chenyurong22/industrial-safety-can/README.md

# Industrial Safety Monitoring CAN Network

A two-node CAN bus safety system built on STM32, demonstrating embedded safety patterns used in automotive and industrial control: message integrity (CRC, counters), heartbeat/watchdog monitoring, and deterministic safe-state transitions. Python-based CAN traffic logger included for analysis.

## Demo

https://github.com/user-attachments/assets/6b3a358f-29fb-43ed-8647-16d2829241f6

*End-to-end demonstration: temperature-driven state changes, live CAN traffic on both consoles, servo actuation, a heartbeat-timeout safe-state trip on bus disconnect, and automatic recovery.*

## Kurzbeschreibung (Deutsch)

Dieses Projekt ist ein sicherheitsgerichtetes CAN-Bus-Netzwerk aus zwei STM32-Knoten. Ein Sensorknoten misst die Temperatur und sendet Datenrahmen mit CRC-Prüfsumme sowie ein Heartbeat-Signal. Ein Überwachungsknoten prüft die Integrität der Nachrichten, steuert einen Aktor zustandsabhängig und geht in einen definierten sicheren Zustand über, wenn der Heartbeat länger als 500 ms ausbleibt. Ein Python-Logger überwacht den Bus unabhängig zur Analyse. Das Projekt orientiert sich an Kommunikations- und Überwachungsmustern aus AUTOSAR-Systemen (z. B. DEM, COM, WdgM), umgesetzt in einfachem HAL-Code.

**Project status:** ✅ Feature complete — 14-day build (Weeks 1–2)

## Table of contents

- [Goals](#goals)
- [CAN frame reference](#can-frame-reference)
- [Hardware](#hardware)
- [Requirements & traceability](#requirements--traceability)
- [Static analysis](#static-analysis)
- [Architecture](#architecture)
- [Repository structure](#repository-structure)
- [Build log](#build-log)
  - [Week 1 — STM32 basics, I2C sensor, UART debugging](#week-1--stm32-basics-i2c-sensor-uart-debugging)
  - [Week 2 — Application-layer integrity, heartbeat, safe state, logging](#week-2--application-layer-integrity-heartbeat-safe-state-logging)
- [Skills demonstrated](#skills-demonstrated)
- [Project achievements](#project-achievements)
- [Author](#author)

## Goals

- Build a working two-node CAN safety network on real hardware
- Demonstrate concepts inspired by communication and supervision patterns commonly used in AUTOSAR systems (e.g. DEM-like diagnostics, COM-like validation, WdgM-like watchdog) in plain HAL code — not AUTOSAR BSW modules themselves
- Produce quantitative timing analysis with a Python logger
- Document the build day-by-day as a learning record

## CAN frame reference

Quick reference for the two message types on the bus (full derivation in the Day 9 and Day 10 build-log entries).

**Sensor frame — CAN ID `0x123`, DLC 8, every 100 ms**

| Byte | 0 | 1 | 2 | 3 | 4–6 | 7 |
|---|---|---|---|---|-----|---|
| Field | Counter | Temp int | Temp frac (×100) | State enum | Reserved | CRC-8 |

State enum: `0 = NORMAL`, `1 = WARNING`, `2 = CRITICAL`. CRC-8 (poly `0x07`) computed over bytes 0–6.

**Heartbeat frame — CAN ID `0x100`, DLC 2, every 200 ms**

| Byte | 0 | 1 |
|---|---|---|
| Field | Counter | Uptime (coarse, `tick/100`) |

Bus: 500 kbit/s, 120 Ω termination at each end, 75 % sample point.

## Hardware

- 2× STM32 Nucleo-F446RE
- 2× SN65HVD230 CAN transceivers
- 1× BME280 temperature/humidity sensor (I2C)
- 1× SG90 servo motor
- 1× Innomaker USB-CAN adapter for PC-side logging
- 120 Ω termination resistors, breadboard, jumper wires

## Requirements & traceability

This project was built against an explicit requirements specification ([`docs/requirements.md`](docs/requirements.md)) — 22 requirements across functional, integrity, and safety categories, each with a rationale and a verification method (test / analysis / inspection) tied to the evidence in the build log below. Requirement IDs are referenced from commit messages to give lightweight V-model traceability from requirement → implementation → demonstrated result.

| Category | IDs | Covers |
|---|-----|---|
| Functional | REQ-F-01 … F-08 | Sensing, state classification with hysteresis, CAN TX/RX, bus parameters, actuation, passive logging |
| Integrity | REQ-I-01 … I-06 | Application-layer CRC-8, rolling counter, lost-frame detection, running statistics, independent PC cross-check |
| Safety | REQ-S-01 … S-08 | Heartbeat liveness, 500 ms watchdog, edge-triggered safe state, fail-safe actuation, auto-recovery, startup grace, rate-limited actuation |

A one-page hazard analysis ([`docs/hara.md`](docs/hara.md)) derives these safety requirements from six identified hazards using an ISO 26262-style Severity / Exposure / Controllability classification.

### Verification matrix

A one-glance view that requirements were actually verified against evidence in the build log. The full per-requirement verification (all 22) is in [`docs/requirements.md`](docs/requirements.md).

| Requirement | What it verifies | Evidence | Status |
|---|---|---|---|
| REQ-F-04 | Sensor frame every 100 ms | Day 9 / Day 13 | ✅ |
| REQ-I-02 | Reject frames failing CRC-8 | Day 9 | ✅ |
| REQ-I-04 | Detect lost frames (counter gap) | Day 9 / Day 11 | ✅ |
| REQ-S-02 | Heartbeat timeout within 500 ms | Day 11 / Day 12 (~501 ms) | ✅ |
| REQ-S-04 | Fail-safe servo position on trip | Day 11 | ✅ |
| REQ-S-06 | Auto-recovery on heartbeat return | Day 11 | ✅ |

## Static analysis

Application code is analysed with **Cppcheck** using the **MISRA C:2012** addon.

- **Tool:** Cppcheck (run `cppcheck --version` and record the version here)
- **Standard:** MISRA C:2012
- **Scope:** application source only — HAL/CMSIS excluded via a suppressions list
- **All mechanically-fixable findings corrected** — explicit type conversions (10.4), boolean conditions (14.4), braced `if` bodies (15.6), `switch` default clauses (16.4)
- **Remaining findings are documented justified deviations** on advisory rules:
  - **8.7** internal-linkage recommendations — functions intentionally shared across both nodes, so cannot be `static`
  - **15.5** single-exit style — per-case returns in small lookup functions, kept for clarity

See [`docs/misra_compliance.md`](docs/misra_compliance.md) for the full report, including the before → after finding counts.

## Architecture

Two STM32 nodes as peers on a shared, terminated CAN bus. Node A senses and transmits; Node B validates, supervises, and actuates. A Python logger taps the bus passively for independent analysis.

```
        NODE A  (Sender / Sensor)                       NODE B  (Receiver / Supervisor)
        ┌───────────────────────┐                       ┌───────────────────────────┐
        │ BME280  (I2C)          │                       │ CRC-8 validation          │
        │   ↓                    │                       │   ↓                       │
        │ State machine          │                       │ Counter / lost-frame check│
        │  (hysteresis)          │                       │   ↓                       │
        │   ↓                    │                       │ Heartbeat watchdog (500ms)│
        │ CRC-8 + rolling counter│                       │   ↓                       │
        │   ↓                    │                       │ Safe-state logic          │
        │ CAN TX:                │                       │   ↓                       │
        │  0x123 sensor  (100ms) │                       │ Servo (PWM) — state /     │
        │  0x100 heartbeat(200ms)│                       │   fail-safe actuation     │
        └───────────┬───────────┘                       └─────────────┬─────────────┘
                    │                                                 │
      ══════════════╪═════════════════ CAN BUS (500 kbit/s) ═════════╪══════════════
       120 Ω term ──┤                         │                       ├── 120 Ω term
                    │                          │                       │
                    │                ┌─────────┴──────────┐            │
                    │                │ Python logger      │            │
                    │                │ (listen-only tap)  │            │
                    │                │ CRC + counter      │            │
                    │                │ re-validation, CSV │            │
                    │                └────────────────────┘            │
```

For the full technical reference — module breakdown, protocol, timing budget, scheduler, state machine, and design limitations — see [`docs/architecture.md`](docs/architecture.md).

## Repository structure

```
Industrial Safety Monitoring CAN Network/
├── CAN_Sender_Node/            # Node A — sensor node: BME280 read, state machine, CAN TX with integrity
├── CAN_Receiver_Node/          # Node B — validator node: CAN RX, CRC + counter validation, watchdog, servo
├── Python Log Code/            # Day 13 — listen-only CAN logger (can_logger.py) + matplotlib report (can_report.py)
├── Project-Snaps/              # screenshots and hardware photos, organised by day
├── docs/
│   ├── requirements.md         # requirements specification with verification + traceability
│   ├── hara.md                 # hazard analysis and risk assessment (ISO 26262-style)
│   ├── architecture.md         # software architecture, protocol, timing, scheduler, state machine
│   └── misra_compliance.md     # MISRA-C:2012 static-analysis report
├── cppcheck_suppressions.txt   # HAL/CMSIS suppressions for the MISRA scan
├── LICENSE                     # MIT
└── README.md
```

## Build log

### Week 1 — STM32 basics, I2C sensor, UART debugging

#### Day 1 (2026-05-13) — Toolchain setup and LED blink

Validated the STM32CubeMX → STM32CubeIDE workflow on a Nucleo-F446RE. Used Board Selector to generate a baseline project — this pre-configures the system clock, PA5 (user LED LD2), PC13 (user button B1), and routes USART2 (PA2/PA3) to the ST-Link virtual COM port. Configured the code generator to emit one `.c/.h` file per peripheral (cleaner than the default single-file dump) and to preserve user code between `/* USER CODE BEGIN ... */` markers on regeneration.

Implemented LED blink three ways to internalise the abstraction layers:
- `HAL_GPIO_TogglePin(LD2_GPIO_Port, LD2_Pin)` — HAL wrapper, function call
- `GPIOA->ODR ^= GPIO_ODR_OD5` — CMSIS read-modify-write
- `GPIOA->BSRR = GPIO_BSRR_BS5` — CMSIS atomic single-cycle write (preferred for ISR safety)

Covered why the BSRR pattern matters once interrupts share a GPIO port with the main loop — a foundation for the multi-LED status indicators planned for Node A.

<p align="center">
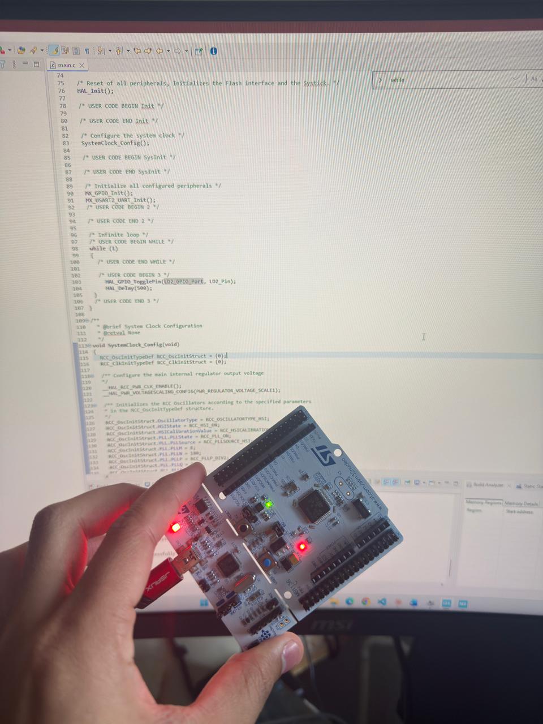
[picture p1: Project-Snaps/day01-blink-toolchain/04-led-blink-hardware.jpeg]
  
  <br>
  <em>First firmware running on hardware — green LD2 blinking at 1 Hz on the Nucleo-F446RE.</em>
</p>

<details>
<summary>Setup screenshots</summary>

<p align="center">
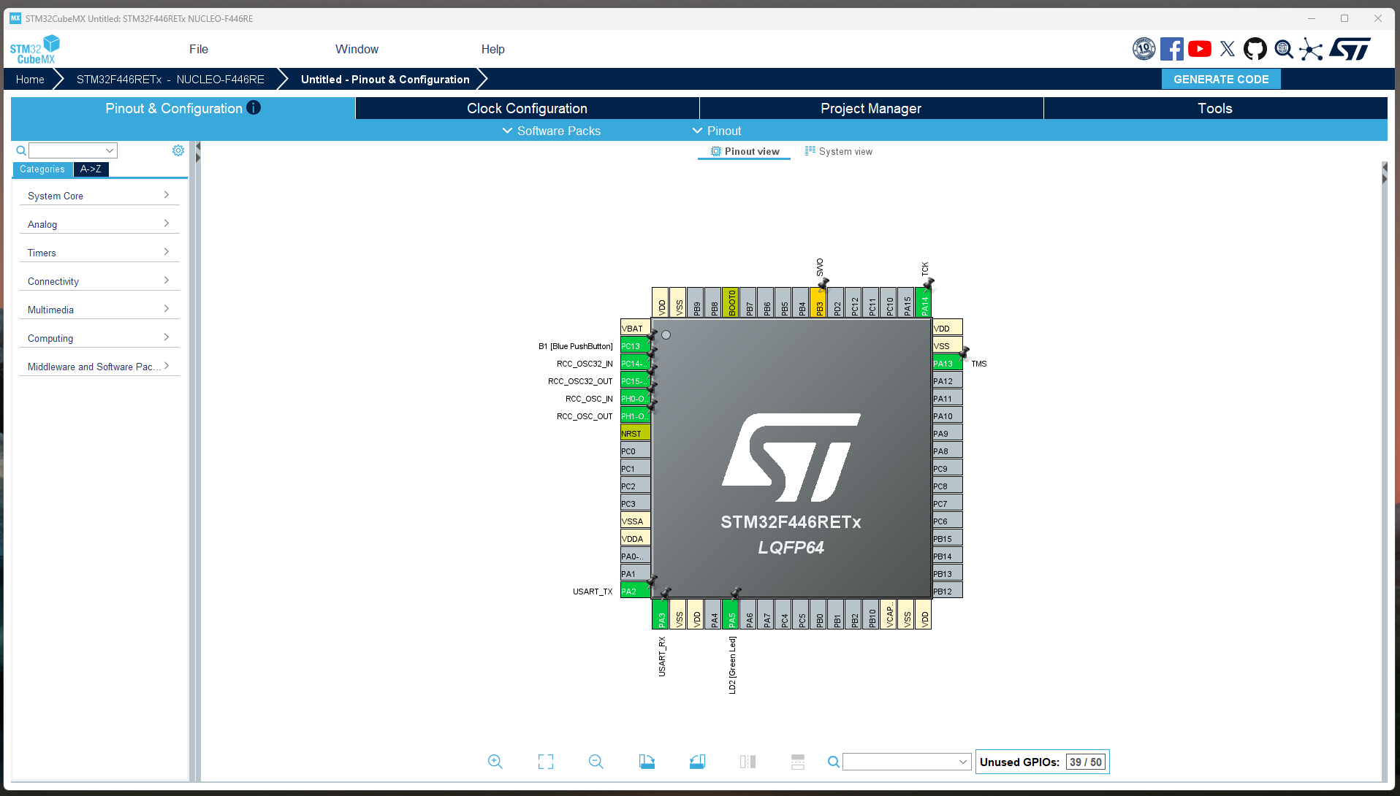
[picture p2: Project-Snaps/day01-blink-toolchain/01-cubemx-board-selector-pinout.png]
  
  <br>
  <em>CubeMX Board Selector pinout view — PA5 (LD2), PA2/PA3 (USART2), PC13 (B1) pre-configured.</em>
</p>

<p align="center">
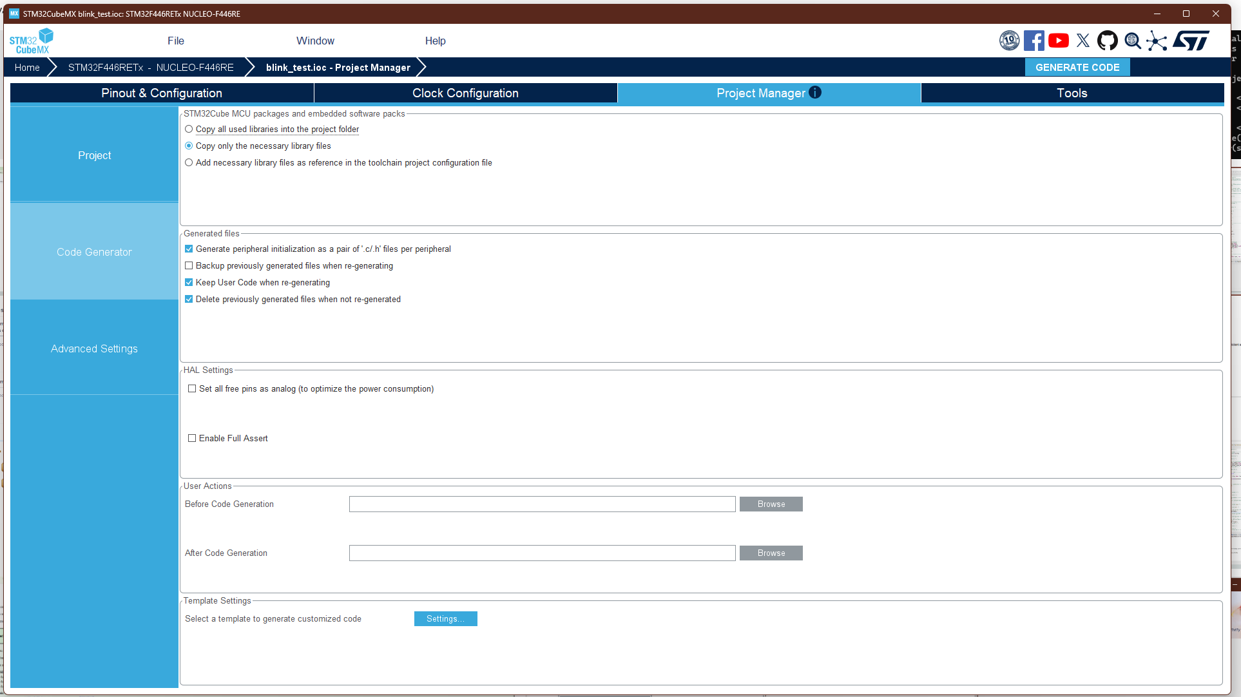
[picture p3: Project-Snaps/day01-blink-toolchain/02-cubemx-code-generator-settings.png]
  
  <br>
  <em>Code Generator settings — per-peripheral file split and user-code preservation enabled.</em>
</p>

<p align="center">
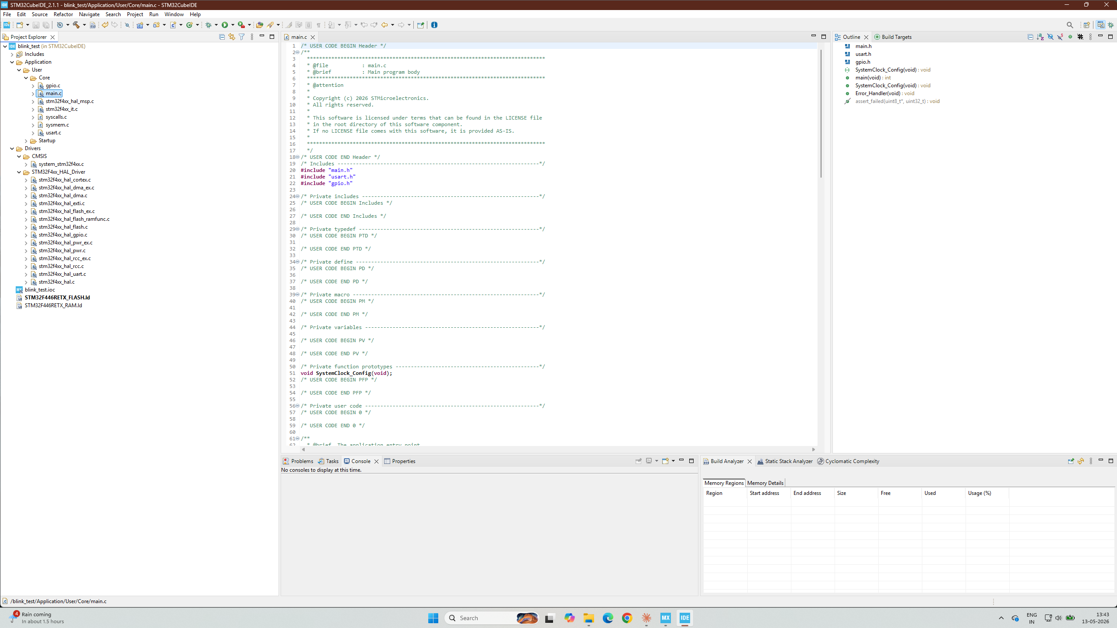
[picture p4: Project-Snaps/day01-blink-toolchain/03-cubeide-project-structure.png]
  
  <br>
  <em>Generated project structure in STM32CubeIDE.</em>
</p>

</details>

#### Day 2 (2026-05-14) — UART printf debugging via ST-Link virtual COM port

Retargeted stdout to USART2 (115200 8N1) by overriding the `_write()` syscall to forward bytes through `HAL_UART_Transmit`. The Nucleo's onboard ST-Link MCU also acts as a USB-to-serial bridge, so no extra hardware is required for the PC to see the output. Boot banner includes `__DATE__`/`__TIME__` compiler macros — a sanity check that the firmware currently running matches the most recent build.

Implemented an in-line `printf` profiler using `HAL_GetTick()` before and after each print call.

**Measurements:**
- Boot-to-first-output: ~5 ms (clock-tree stabilisation + boot banner transmission)
- Each printf at 115200 baud: ~2–3 ms, dominated by serial transmit time (each character ≈87 µs on the wire; `HAL_UART_Transmit` blocks until the last byte has left)
- Nominal 500 ms `HAL_Delay` loop drifts to 503–505 ms once printing is added — the observer effect on timing

This is the first quantitative observation of how blocking I/O distorts deterministic scheduling — directly motivates the FreeRTOS-vs-bare-metal comparison planned for Project 3.

<p align="center">
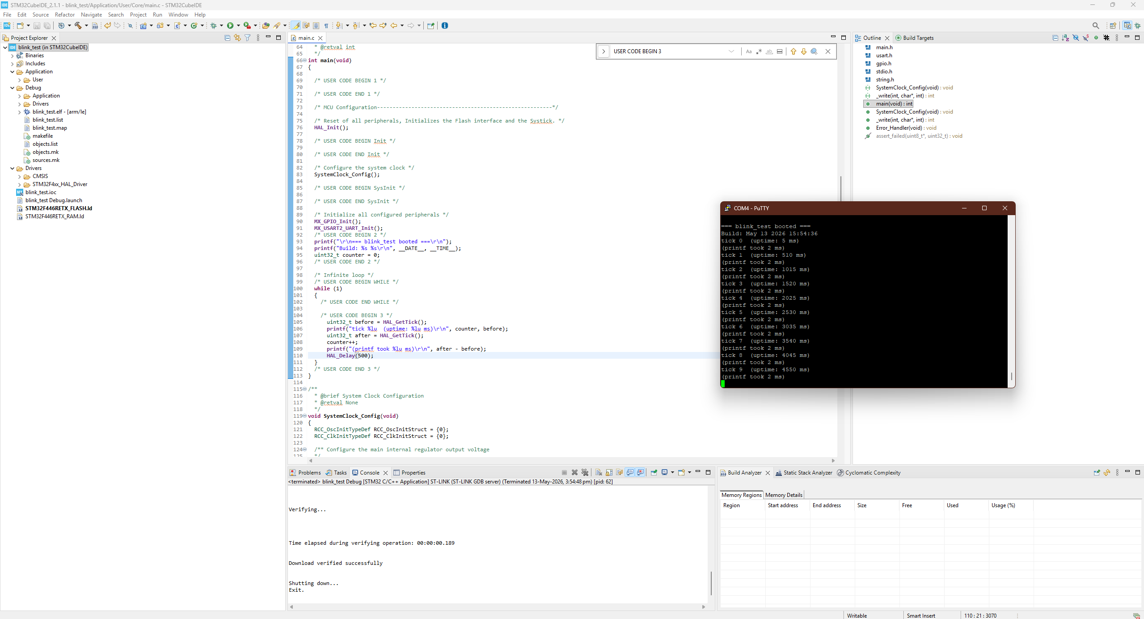
[picture p5: Project-Snaps/day02-uart-printf/03-putty-printf-profiling.png]
  
  <br>
  <em>Live UART output in PuTTY showing tick counter, system uptime, and self-measured printf duration.</em>
</p>

<details>
<summary>Setup and earlier iteration</summary>

<p align="center">
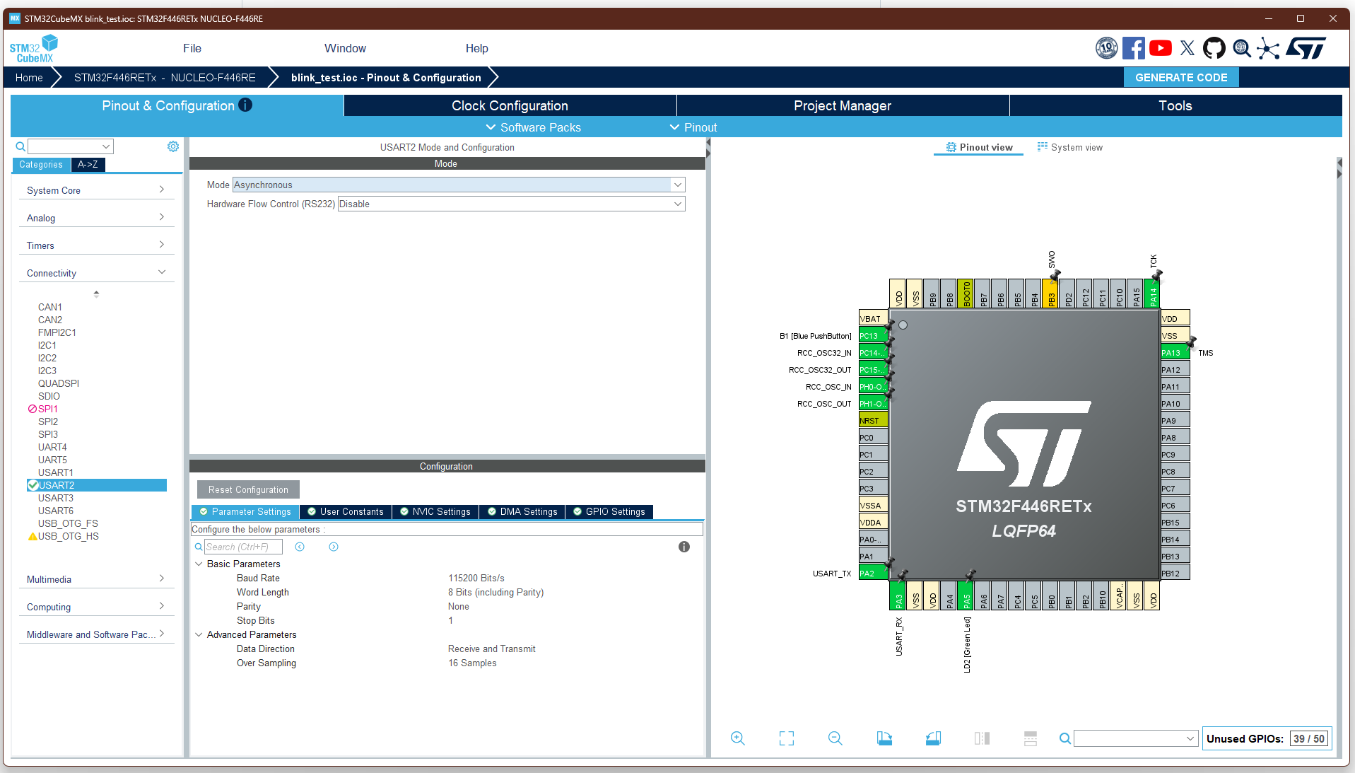
[picture p6: Project-Snaps/day02-uart-printf/01-cubemx-usart2-config.png]
  
  <br>
  <em>USART2 configuration in CubeMX: 115200 8N1, hardware flow control disabled.</em>
</p>

<p align="center">
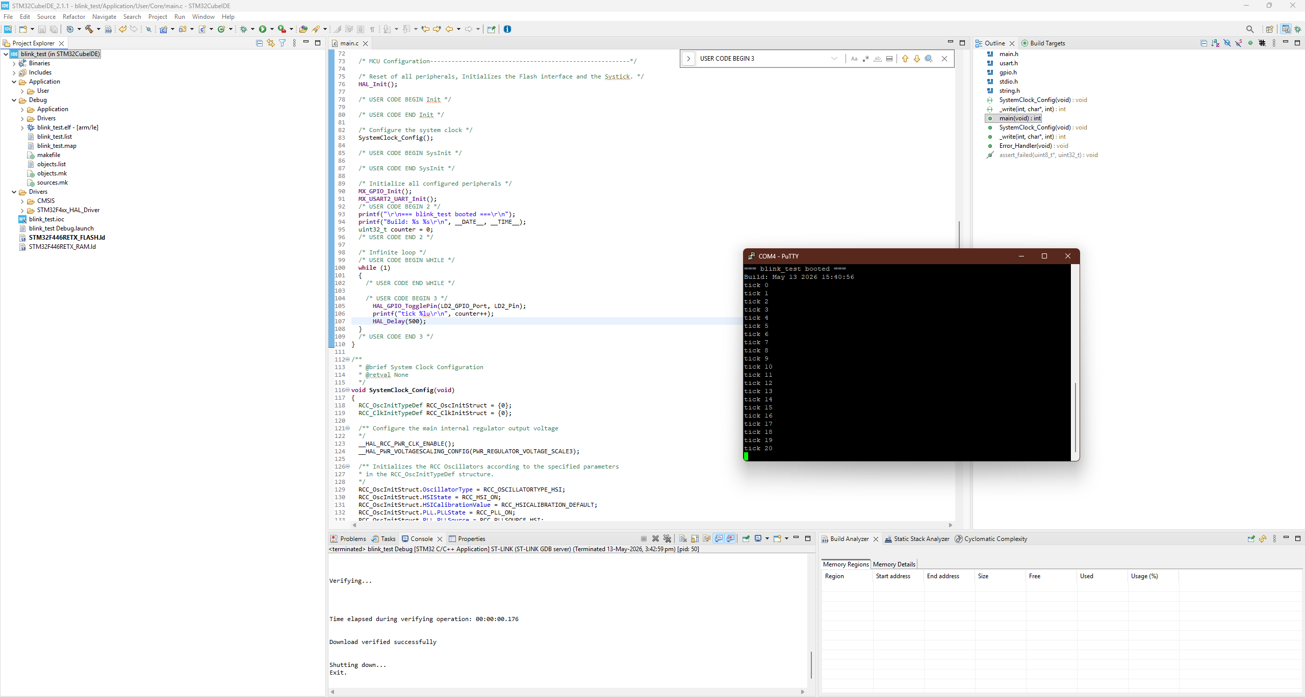
[picture p7: Project-Snaps/day02-uart-printf/02-putty-tick-counter.png]
  
  <br>
  <em>First working UART output — boot banner plus tick counter (before adding uptime/profiling).</em>
</p>

</details>

#### Day 3 (2026-05-15) — I2C bus and BME280 sensor discovery

Enabled I2C1 peripheral on PB8 (SCL) and PB9 (SDA) at 100 kHz Standard Mode via CubeMX. Validated the regeneration workflow: reopened the `.ioc`, enabled a new peripheral, regenerated code, and confirmed that previously-written user code inside `/* USER CODE BEGIN ... */` markers survived intact — this is the workflow that scales as the project grows.

Wired a BME280 temperature/humidity/pressure sensor breakout to the Nucleo's Arduino-compatible header (VIN → 3V3, GND → GND, SCL → D15/PB8, SDA → D14/PB9). Implemented two operations at boot:

1. **I2C bus scanner** — iterates all 127 possible 7-bit addresses, calling `HAL_I2C_IsDeviceReady` on each. Any address that ACKs gets printed.
2. **Chip ID verification** — once a device is found, reads register `0xD0` via `HAL_I2C_Mem_Read`. The BME280 datasheet guarantees this register returns `0x60`. Matching value confirms not just I2C connectivity, but that the correct sensor type is on the bus (vs. e.g. the older BMP280 which returns `0x58`).

Covered the HAL address-shifting convention (`<< 1` to make space for the read/write bit) — the most common single source of "I2C silently doesn't work" bugs in STM32 code.

<p align="center">
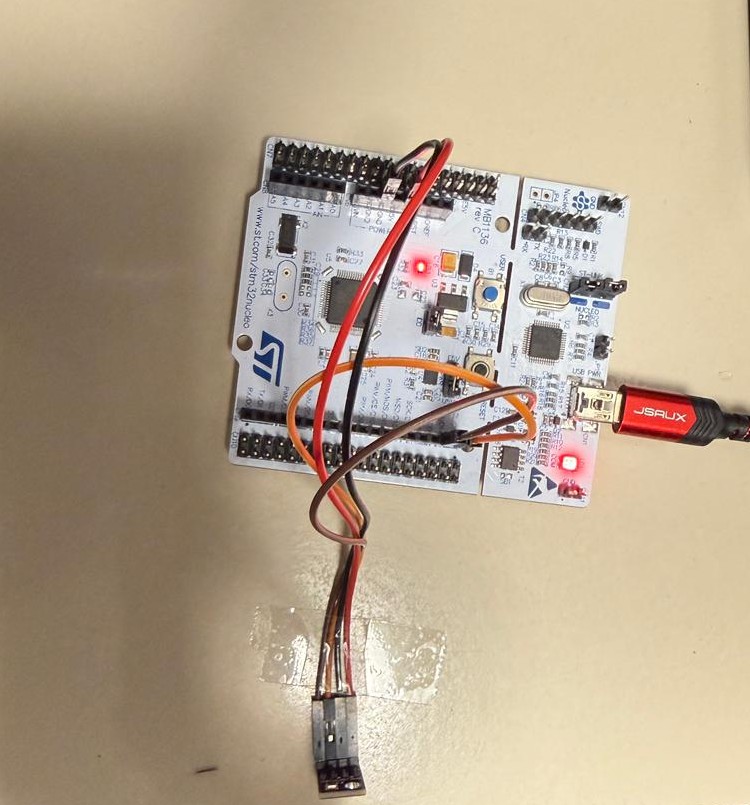
[picture p8: Project-Snaps/day03-i2c-bme280/02-bme280-wiring.jpeg]
  
  <br>
  <em>BME280 sensor wired to the Nucleo over I2C — VIN, GND, SCL, SDA on the Arduino-compatible header.</em>
</p>

<p align="center">
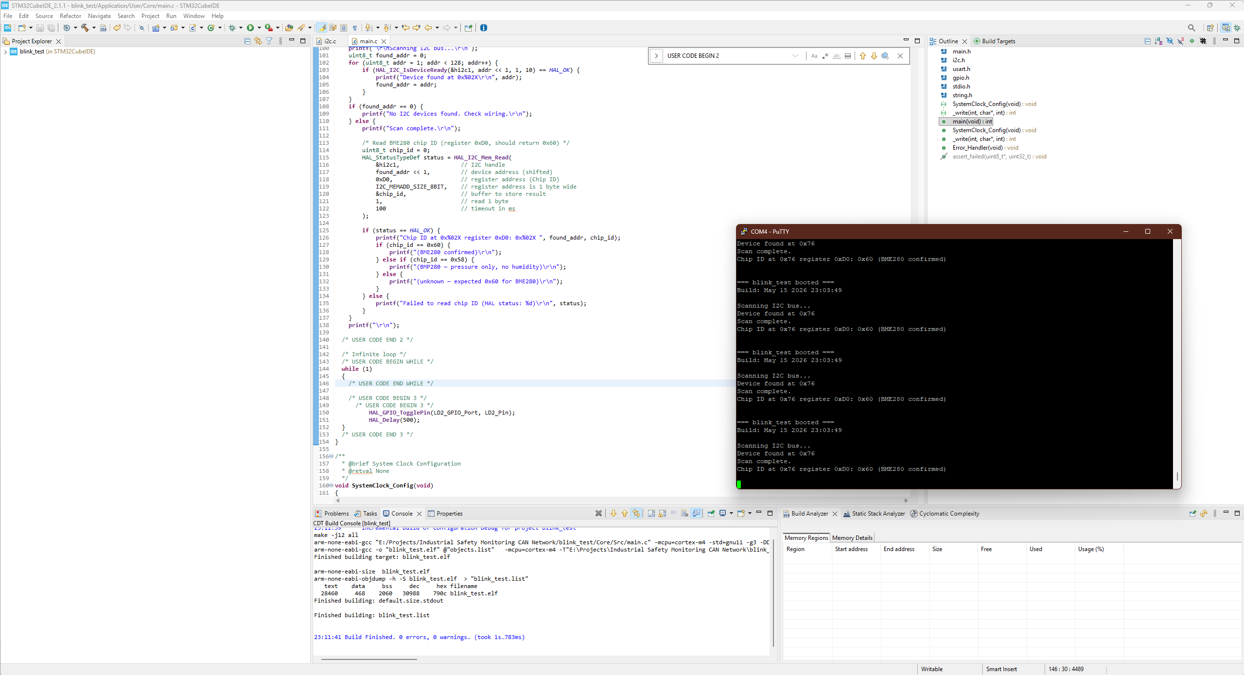
[picture p9: Project-Snaps/day03-i2c-bme280/03-putty-bme280-detected.png]
  
  <br>
  <em>Boot output: I2C scanner finds the sensor at 0x76; chip ID read at register 0xD0 returns 0x60, confirming the device is a genuine BME280.</em>
</p>

<details>
<summary>CubeMX I2C configuration</summary>

<p align="center">
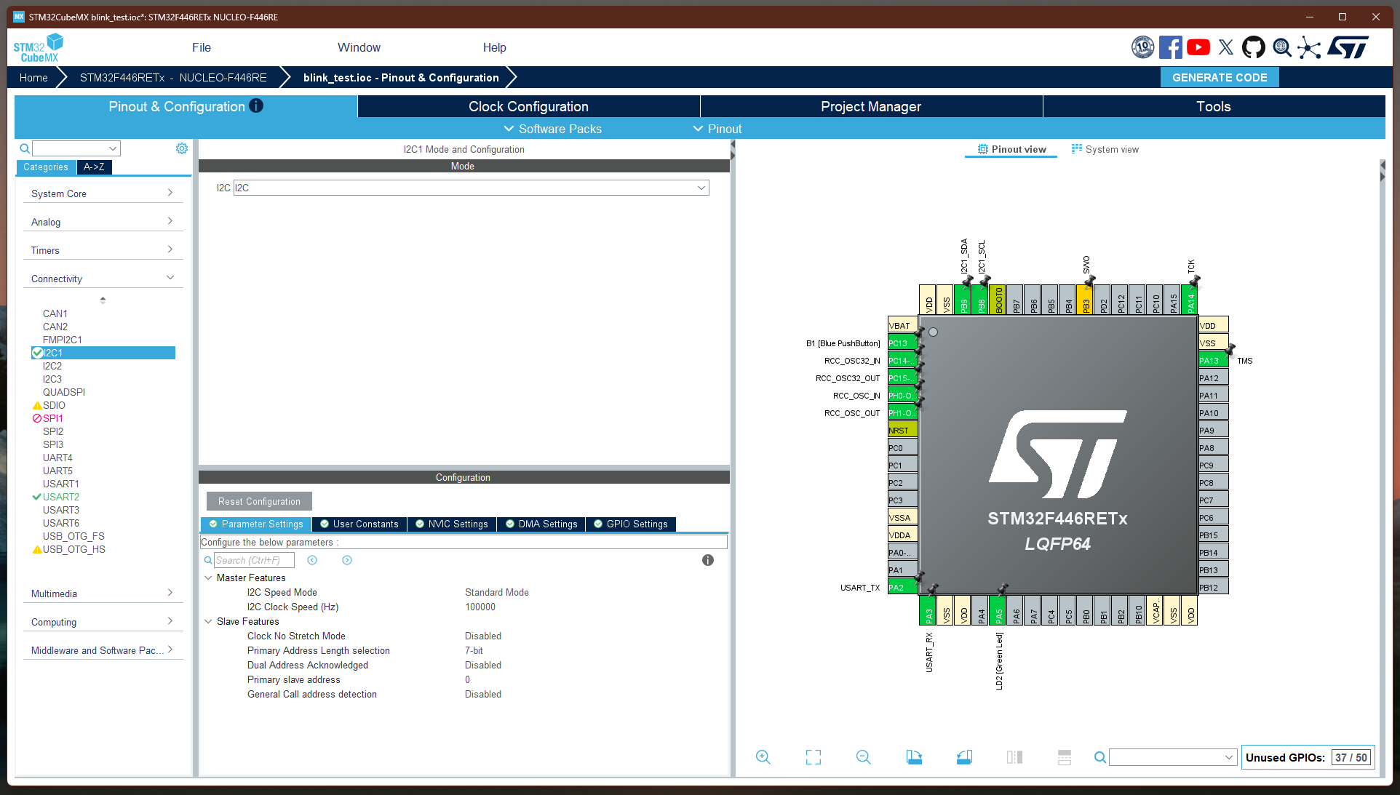
[picture p10: Project-Snaps/day03-i2c-bme280/01-cubemx-i2c1-config.png]
  
  <br>
  <em>I2C1 peripheral configured: Standard Mode, 100 kHz, 7-bit addressing. PB8/PB9 auto-routed as SCL/SDA.</em>
</p>

</details>

#### Day 4 (2026-05-17) — Live temperature, humidity, and pressure readings

Extended the BME280 work from chip-ID discovery to full sensor operation. Created dedicated driver files (`bme280.h` / `bme280.c`) to keep `main.c` focused on application logic — the structural pattern used in production embedded code.

Implementation steps:
1. **Read 26 bytes of calibration data** from registers `0x88..0xA1` and another 7 bytes from `0xE1..0xE7` at init. Each BME280 chip is factory-calibrated; these coefficients are unique per device and must be read from the chip's non-volatile memory.
2. **Configure measurement mode** — wrote `0xF2 = 0x01` (humidity oversampling ×1), `0xF4 = 0x27` (temp ×1, pressure ×1, normal continuous mode), `0xF5 = 0xA0` (1000 ms standby, filter off).
3. **Read 8 bytes of raw measurement** from `0xF7..0xFE` every second — 20-bit raw values for pressure, temperature, and humidity in a single I2C transaction.
4. **Apply Bosch's compensation algorithm** (datasheet section 4.2.3) — converts raw ADC values plus calibration coefficients into real-world units (°C, %RH, hPa). The math uses `int32_t` and `int64_t` intermediates with careful sign handling; copied verbatim from the official reference driver.

**Live readings confirm:** temperature ~28 °C (sensor self-heats ~2 °C above ambient), humidity ~65% RH, pressure ~998 hPa (consistent with Friedberg elevation). Breathing on the sensor pushes humidity above 80% within two samples, validating that real environmental coupling works.

<p align="center">
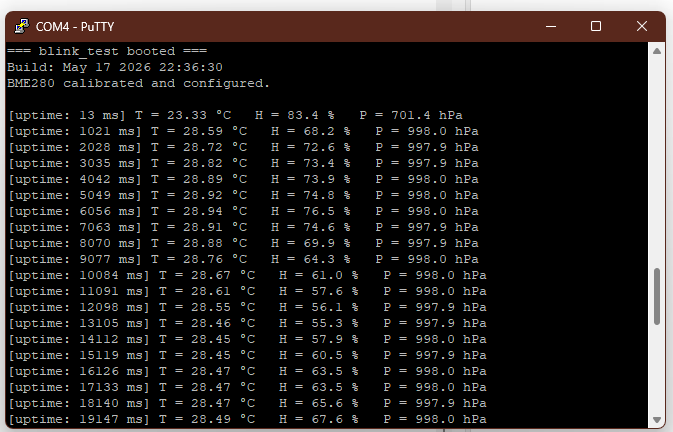
[picture p11: Project-Snaps/day04-bme280-readings/01-putty-live-readings.png]
  
  <br>
  <em>Continuous BME280 readings — temperature, humidity, and pressure printed every second over UART.</em>
</p>

<details>
<summary>Driver files and validation</summary>

<p align="center">
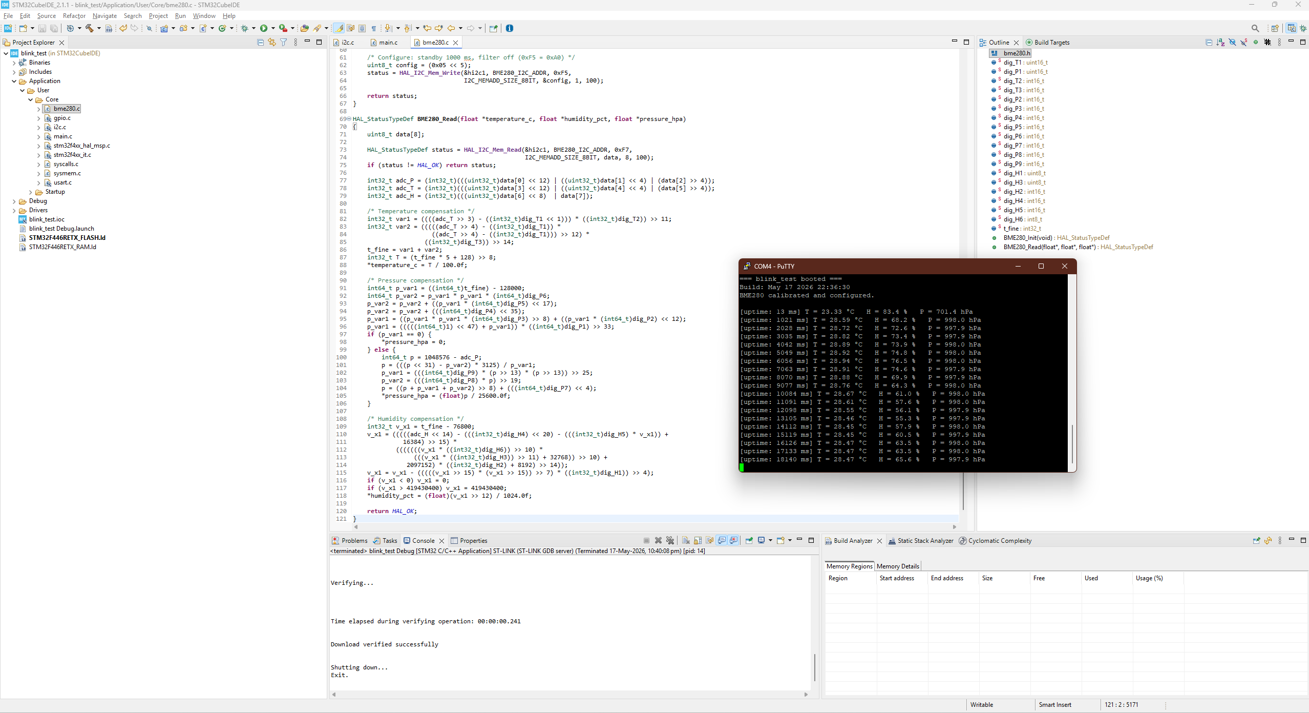
[picture p12: Project-Snaps/day04-bme280-readings/02-bme280-C_file.png]
  
  <br>
  <em>BME280 driver (<code>bme280.c</code>) showing the algorithm, with live readings in PuTTY confirming the math produces valid real-world values.</em>
</p>

</details>

#### Day 5 (2026-05-19) — Temperature state classification and transition detection

Built a three-state safety classifier on top of the BME280 driver. Temperature thresholds: `≤ 30 °C → NORMAL`, `30 – 45 °C → WARNING`, `> 45 °C → CRITICAL`. Implemented in three composable pieces:

1. **`classify_state(float)`** — pure function mapping temperature to a `SystemState` enum value. No side effects; trivially testable. Threshold cascade evaluated most-severe-first to prevent overlap bugs.
2. **Edge-triggered transition detection** — `current_state` vs `previous_state` comparison in the main loop. State-change events are logged prominently with `*** STATE CHANGE: X -> Y ***`, while steady-state samples log normally. Critically, `previous_state` is only updated on detected transitions — the same edge-detection pattern used by debouncers, ISRs, and AUTOSAR's DEM module.
3. **State-driven feedback** — the LD2 blink rate is derived from the current state (`1 Hz` calm / `4 Hz` warning / `10 Hz` alarm) via `HAL_Delay(blink_interval_ms(state))`. The blink itself becomes a visual state indicator without needing external hardware.

Validated experimentally: pinching the sensor between fingers heats it past 30 °C → WARNING. A phone flashlight held against it pushes past 45 °C → CRITICAL. Both transitions and the reverse directions logged cleanly.

This is the same classify → detect-edge → react pattern that Node A will use in Week 2 to decide when to emit CAN state-change events.

<p align="center">
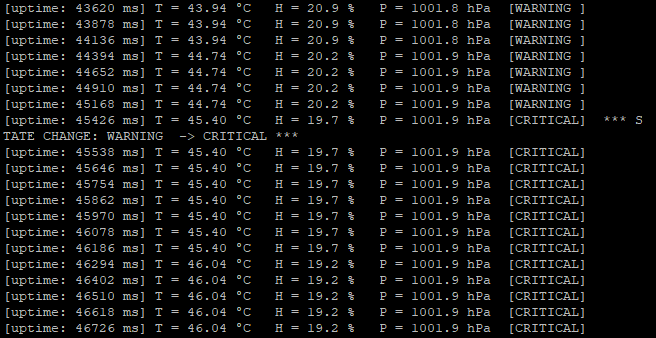
[picture p13: Project-Snaps/day05-state-machine/03-transition-warning-to-critical.png]
  
  <br>
  <em>WARNING → CRITICAL transition at 45.4 °C — the threshold crossing is logged with full sensor context plus a prominent state-change marker.</em>
</p>

<details>
<summary>Other states and transitions</summary>

<p align="center">
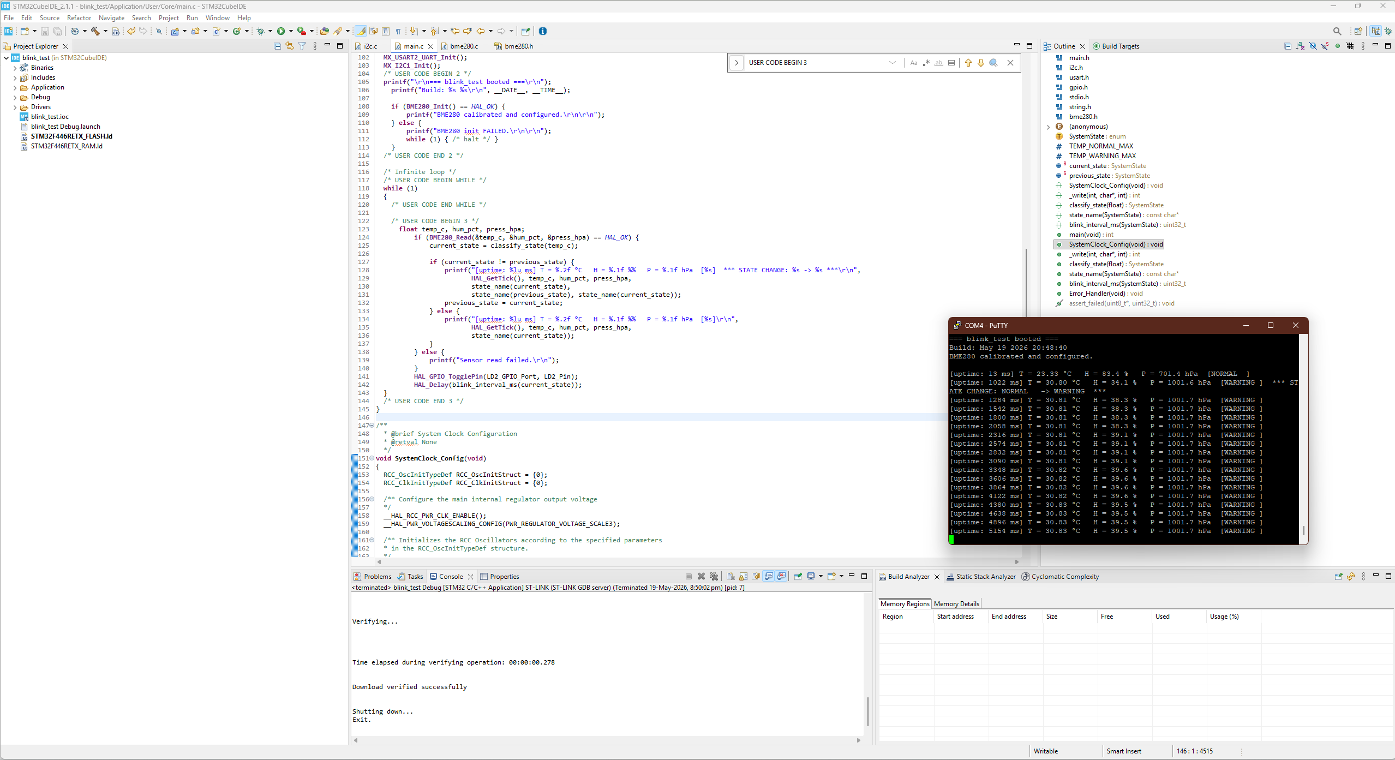
[picture p14: Project-Snaps/day05-state-machine/01-normal-state-steady.png]
  
  <br>
  <em>Steady NORMAL state at room temperature — uniform output, slow blink rate.</em>
</p>

<p align="center">
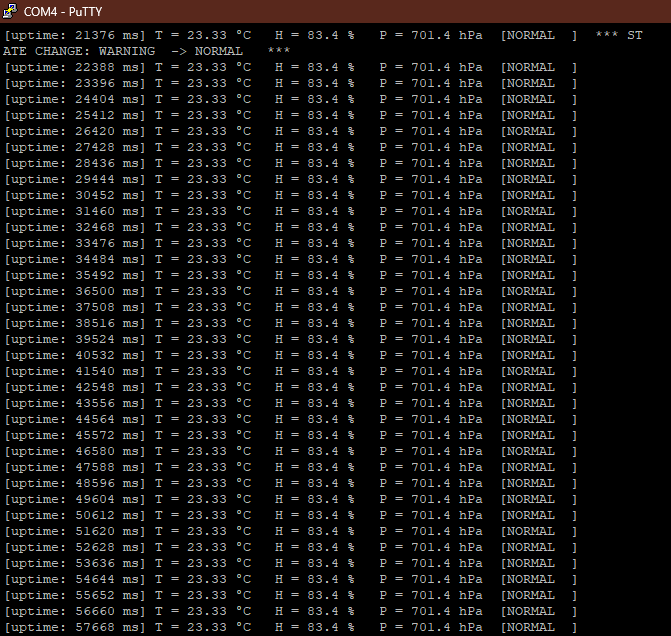
[picture p15: Project-Snaps/day05-state-machine/02-transition-normal-to-warning.png]
  
  <br>
  <em>NORMAL → WARNING transition triggered by finger contact heating the sensor past 30 °C.</em>
</p>

<p align="center">
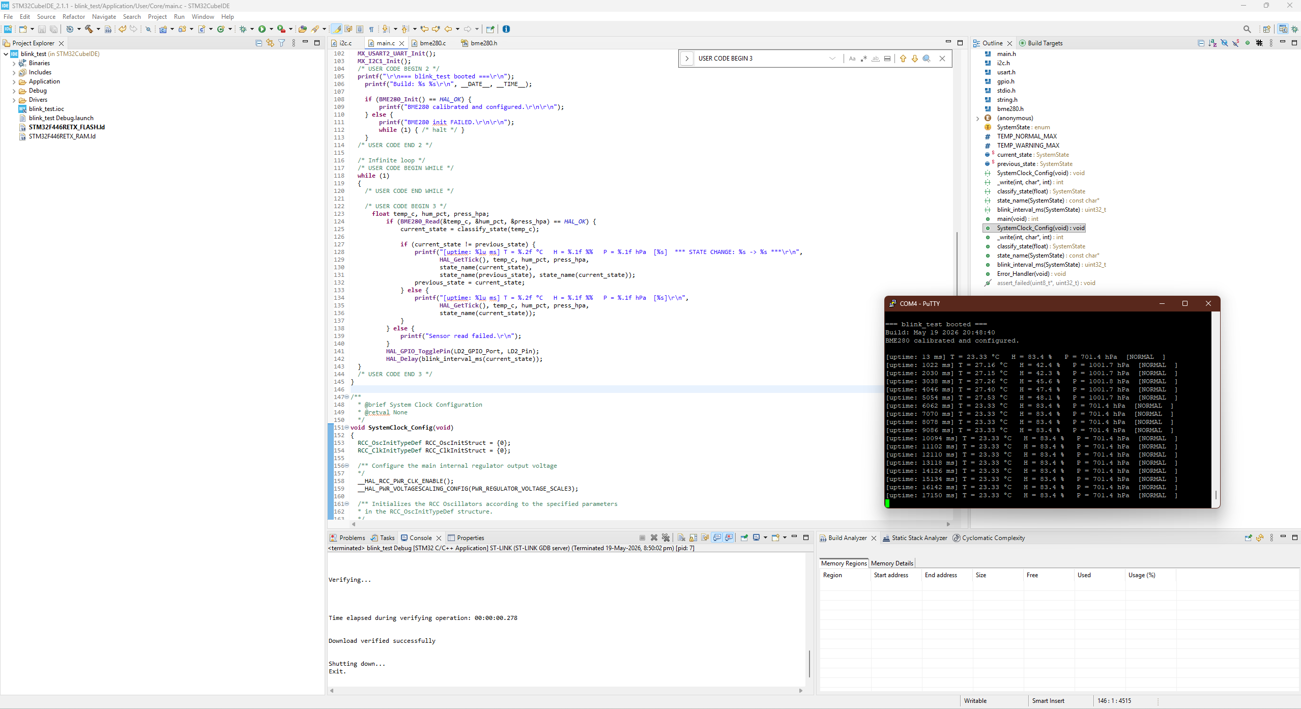
[picture p16: Project-Snaps/day05-state-machine/04-cubeide-code-warning-state.png]
  
  <br>
  <em>Main loop code with state-aware printf and state-derived blink interval, alongside live WARNING-state output.</em>
</p>

</details>

#### Day 6 (2026-05-20) — Modular refactor and hysteresis

Two clean-up tasks before introducing CAN complexity next week.

**Refactor.** Extracted the state-machine logic out of `main.c` into its own module: `state_machine.h` (public API, threshold definitions, enum) and `state_machine.c` (implementations). As of Day 6 the codebase has three clear layers: hardware drivers (`bme280.*`), policy (`state_machine.*`), and orchestration (`main.c`). Same architectural pattern as Day 4's BME280 driver — one file per responsibility.

**Hysteresis.** Day 5's threshold-based classifier had a subtle flaw: temperature wobbling near a boundary (e.g. 29.9 ↔ 30.1 °C) would rapidly toggle `NORMAL ↔ WARNING` many times per second. In a real safety system this would generate runaway CAN traffic and bury operators in alarm spam. Fix: separate rising and falling thresholds with a 2 °C deadband.

- `NORMAL → WARNING` triggers at **30.0 °C** (rising)
- `WARNING → NORMAL` triggers at **28.0 °C** (falling) — must drop 2 °C below entry point
- `WARNING → CRITICAL` triggers at **45.0 °C** (rising)
- `CRITICAL → WARNING` triggers at **43.0 °C** (falling)

Implementation: `classify_state()` gained a second argument (`current` state) and a `switch` on it — different threshold logic applies depending on which state you're already in. This is the structure used by industrial thermostats, ECU temperature monitors, and AUTOSAR's diagnostic event qualifiers.

Validated experimentally with two clean transitions: room temperature → finger-warmed past 30 °C → flashlight-heated past 45 °C, with hysteresis holding cleanly at both boundaries (no flicker).

<p align="center">
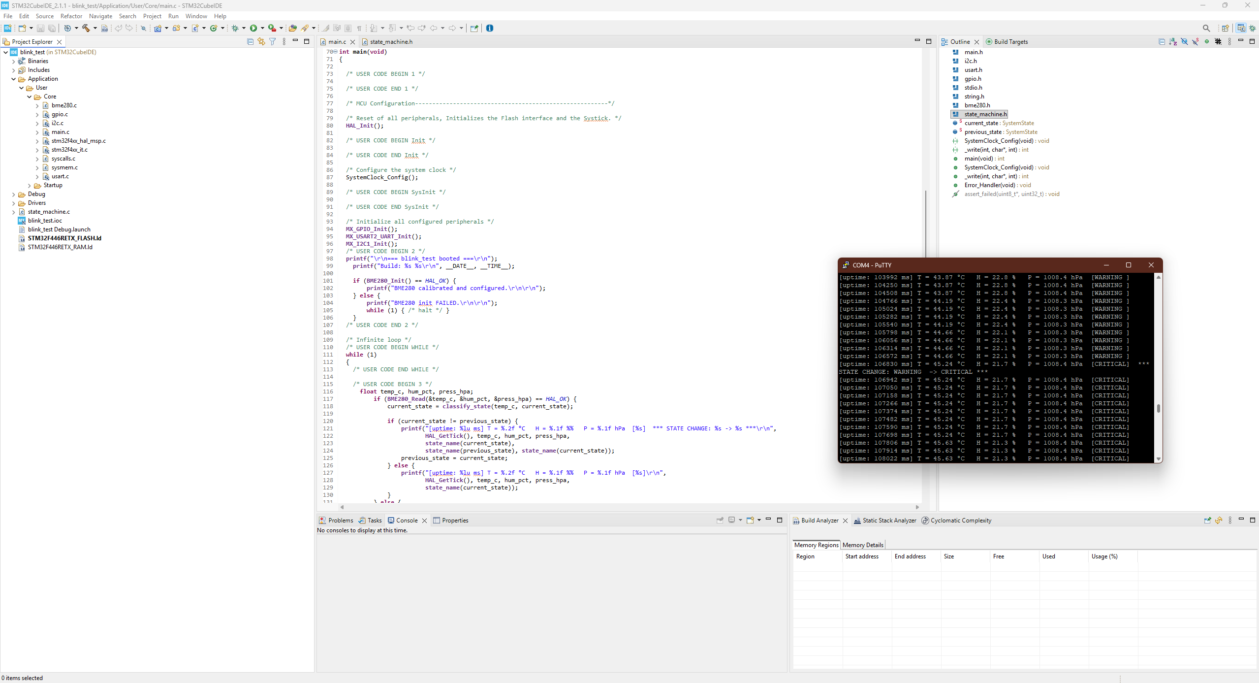
[picture p17: Project-Snaps/day06-refactor-hysteresis/03-transition-warning-to-critical.png]
  
  <br>
  <em>WARNING → CRITICAL transition at 45.24 °C — sustained CRITICAL state without flapping back down through the 43 °C exit threshold.</em>
</p>

<details>
<summary>Other transitions and module layout</summary>

<p align="center">
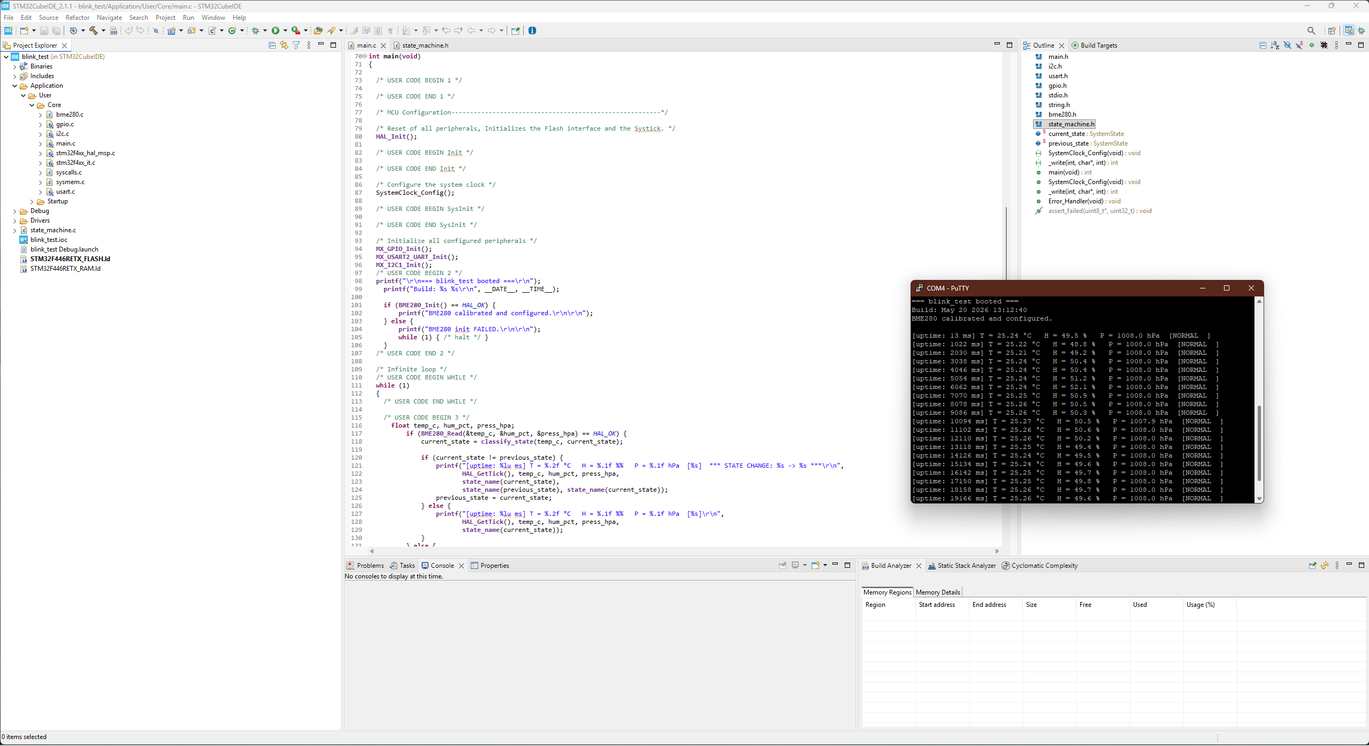
[picture p18: Project-Snaps/day06-refactor-hysteresis/01-normal-steady-with-module.png]
  
  <br>
  <em>Steady NORMAL state at room temperature (~25 °C). Project Explorer (left) shows the new <code>state_machine.c</code> file alongside <code>bme280.c</code>; Outline panel (right) shows <code>state_machine.h</code> contents.</em>
</p>

<p align="center">
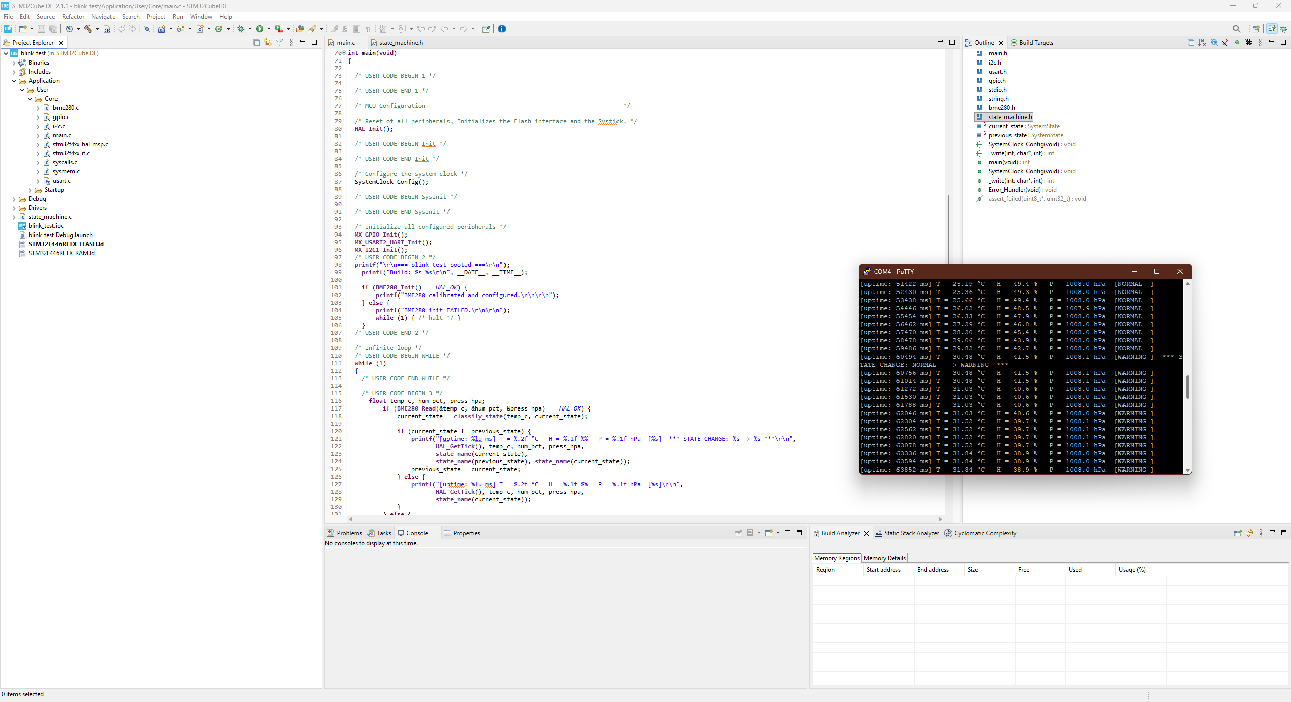
[picture p19: Project-Snaps/day06-refactor-hysteresis/02-transition-normal-to-warning.png]
  
  <br>
  <em>NORMAL → WARNING transition at 30.48 °C, followed by sustained WARNING state with rising temperature (31.03 → 31.84 °C).</em>
</p>

</details>

#### Day 7 (2026-05-22) — CAN1 peripheral enabled, loopback validation

First CAN milestone. Enabled CAN1 in CubeMX and validated the full TX/RX path in **loopback mode** — the peripheral internally wires its TX line back to its own RX input, bypassing the transceiver and external bus. This lets us exercise the filter, mailboxes, ISR path, and bit timing without needing a second board or wired bus.

**Build sequence:**
1. Enabled CAN1 in CubeMX, mapped to the available pins on this specific Nucleo board layout (`CAN_MODE_LOOPBACK`, ~500 kbit/s effective). Mapping required board-specific verification — the headline RM pins weren't physically accessible the way the datasheet suggested.
2. NVIC: enabled `CAN1 RX0 interrupt` so frame-arrival events drive an ISR rather than polling.
3. Wrote the test fixture: `CAN_TestInit()` configures an accept-all filter (mask = 0), starts the peripheral, activates the FIFO0 notification, and sets up a `tx_header` for standard 11-bit ID `0x123` with 4-byte payload.
4. Main loop: each iteration increments a counter, calls `HAL_CAN_AddTxMessage` (non-blocking — frame goes to a hardware mailbox and transmits in the background), waits 50 ms, then checks `can_rx_flag` set by the ISR callback.

**Receive path** is interrupt-driven. The hardware FIFO0 raises an IRQ when a frame arrives; CubeMX's `CAN1_RX0_IRQHandler` calls `HAL_CAN_IRQHandler`, which calls the **weak symbol** `HAL_CAN_RxFifo0MsgPendingCallback` — overridden in `main.c` to pull the frame via `HAL_CAN_GetRxMessage` and raise a flag. This is the standard HAL extension pattern. The `volatile` qualifier on the flag is essential — without it the compiler may cache the loop-side read in a register and miss the ISR update.

**Result:** every transmitted frame round-trips through the peripheral and arrives intact at the RX FIFO. Counter increments monotonically, all data bytes match, "OK match" on every cycle.

<p align="center">
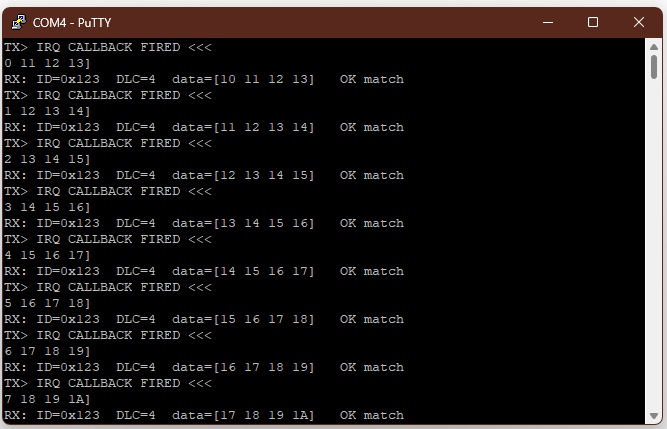
[picture p20: Project-Snaps/day07-can-loopback/02-putty-loopback-frames.png]
  
  <br>
  <em>CAN loopback test: TX increments counter, the ISR callback fires for each frame, RX data matches TX exactly. Eight consecutive successful round trips.</em>
</p>

<details>
<summary>Code context and hardware</summary>

<p align="center">
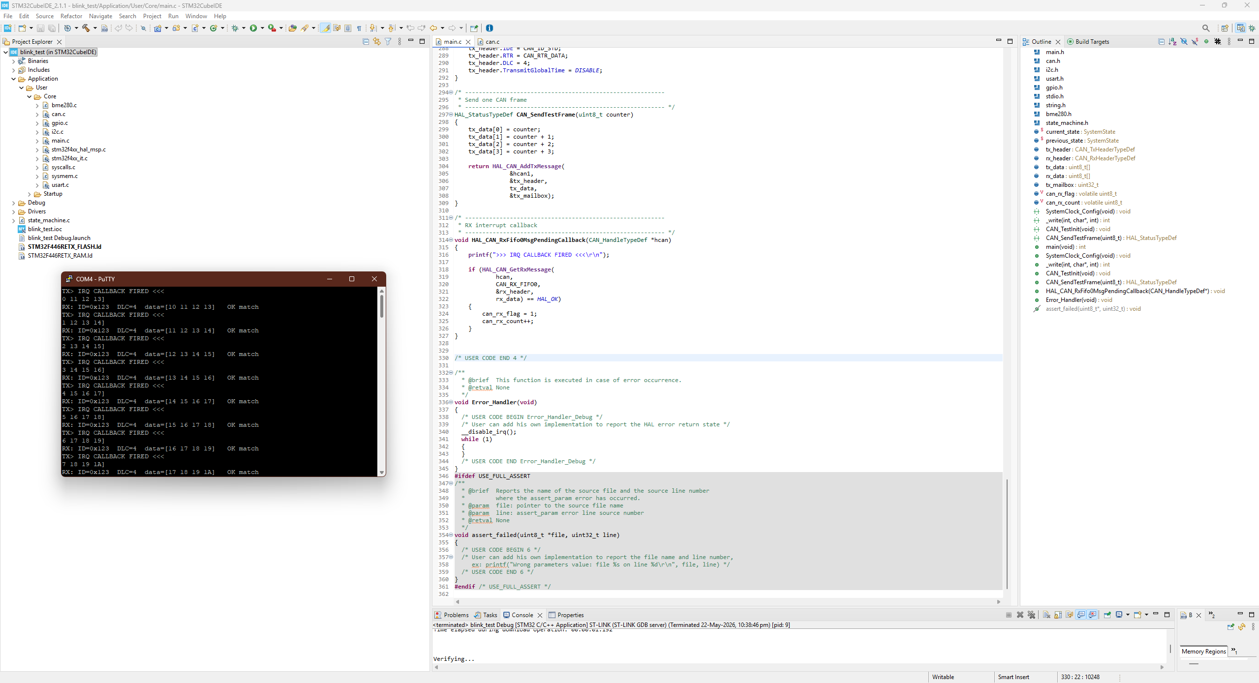
[picture p21: Project-Snaps/day07-can-loopback/01-loopback-success-with-code.png]
  
  <br>
  <em>CubeIDE Project Explorer shows the new <code>can.c</code> driver alongside <code>bme280.c</code>, <code>state_machine.c</code>; Outline panel shows the CAN handle types and ISR callback registration.</em>
</p>

<p align="center">
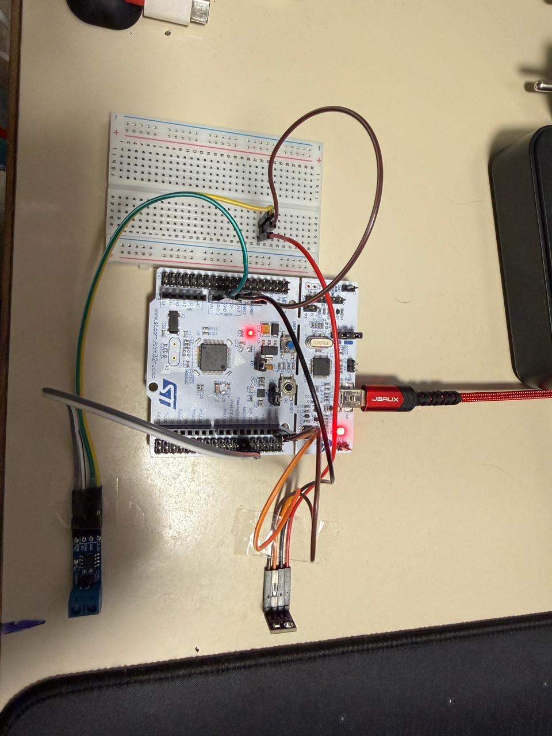
[picture p22: Project-Snaps/day07-can-loopback/03-hardware-setup.jpg]
  
  <br>
  <em>Hardware setup at end of Day 7 — Nucleo-F446RE with BME280 sensor (I2C, four-wire ribbon at right) and SN65HVD230 CAN transceiver (blue board at bottom-left, wired to STM32 but with CANH/CANL unconnected since loopback mode bypasses the transceiver internally). The transceiver wiring is staged ahead of Day 8's two-node bus setup.</em>
</p>

</details>

#### Day 8 (2026-06-01) — Two-board CAN bus, transceivers carrying real signals

The transition from "peripheral validated" to "real network." Switched CAN1 from loopback to **Normal mode**, wired two SN65HVD230 transceivers via CANH/CANL with **120 Ω termination at each end of the bus**, and built a second Nucleo as a dedicated receiver project. Frames now physically leave the transmitting chip, traverse the differential bus, get ACKed by the receiver, and arrive intact.

**Build sequence:**
1. Reconfigured the sender's CubeMX: Operating Mode → Normal, bit timing tuned to **500 kbit/s** (Prescaler 6, TimeSeg1 11TQ, TimeSeg2 2TQ on 42 MHz APB1). Pins CAN1_TX = PA12, CAN1_RX = PA11.
2. Wired both transceivers identically: VCC↔3V3, GND↔GND, TXD↔CAN1_TX, RXD↔CAN1_RX, RS↔GND (high-speed mode). CANH↔CANH and CANL↔CANL between transceivers, with one 120 Ω resistor across CANH-CANL at each end of the bus.
3. Created `CAN_Receiver_Node` as a separate CubeIDE project (sibling to the sender). Same Workflow A, same per-peripheral file generation, Keep User Code on. Configured CAN1 with identical bit timing to the sender — critical for the two nodes to agree on bit boundaries.
4. Wrote a minimal receiver: `_write` retarget for UART, `CAN_ReceiverInit` with accept-all filter, weak-symbol RX callback override, main loop that prints every received frame with HAL_GetTick timestamp and a monotonic frame counter.

**Why termination matters.** CAN runs as a differential signal on a twisted pair (or any pair). The bus has a characteristic impedance near 120 Ω. Without termination resistors at each end, the signal reflects off the open wire ends back into the bus, creating standing waves that corrupt the differential. Symptom of forgetting termination: TX failures with `HAL_CAN_GetError` returning `0x40` (ACK error) — the receiver can't read the bits cleanly, so it can't ACK.

**Why Normal mode needs two nodes.** Unlike loopback, Normal mode requires at least one other node on the bus to acknowledge each transmission within the ACK slot. A frame sent into an empty bus fails after the automatic retransmission count is exhausted, and the peripheral eventually transitions to bus-off. With the receiver running and ACKing, the sender's transmissions succeed reliably.

**Result:** Node A transmits a counter-payload frame with ID `0x123`, DLC 4. Node B receives every frame in sequence, no gaps, payload matches exactly. From cold boot, first transmission to first reception completes in 8 ms.

<p align="center">
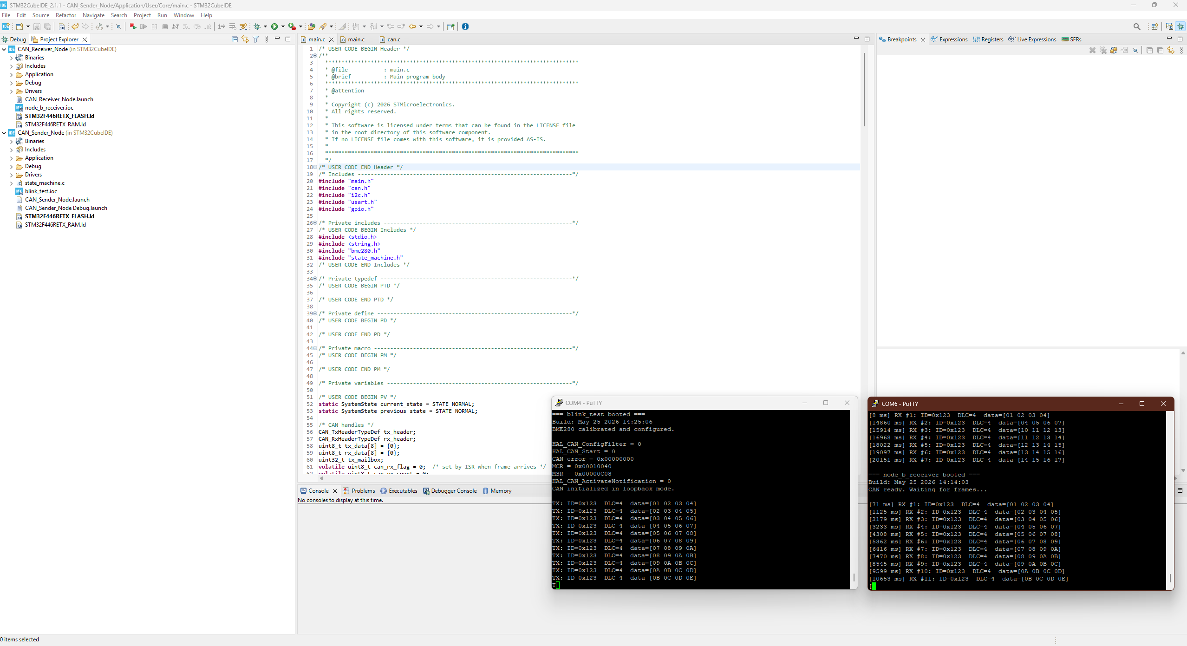
[picture p23: Project-Snaps/day08-two-board-can/01-dual-projects-with-output.png]
  
  <br>
  <em>Both projects open in the same CubeIDE workspace (<code>CAN_Sender_Node</code> and <code>CAN_Receiver_Node</code>) with their PuTTY consoles. Left console (COM4 — sender): full boot sequence, CAN init diagnostics, then continuous TX. Right console (COM6 — receiver): independent boot banner, then RX frames matching the sender's payload frame-for-frame starting at 8 ms after Node B comes online.</em>
</p>

<details>
<summary>CubeMX configuration and close-up of the dual-console output</summary>

<p align="center">
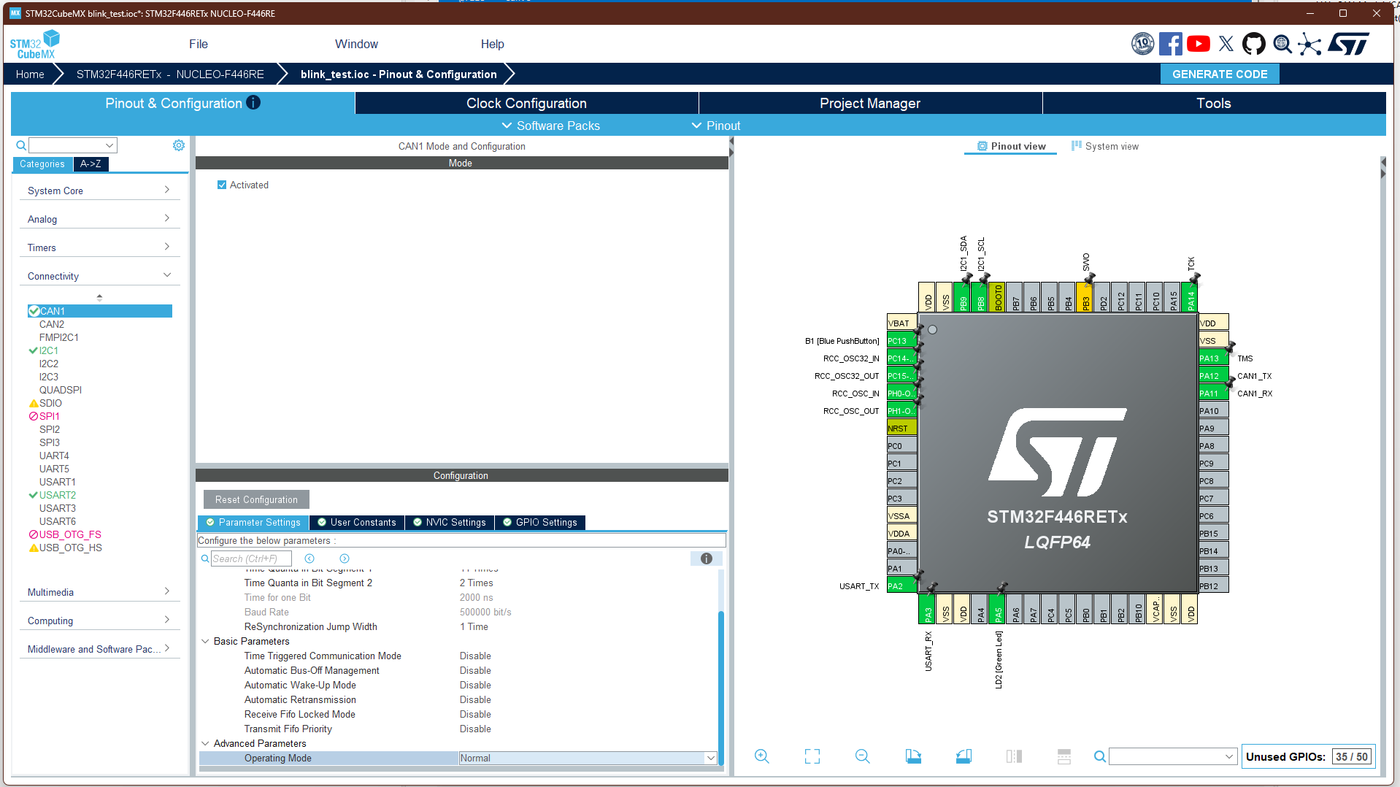
[picture p24: Project-Snaps/day08-two-board-can/03-cubemx-can1-normal-pinout.png]
  
  <br>
  <em>CubeMX CAN1 configuration on Nucleo-F446RE: <strong>CAN1_TX → PA12, CAN1_RX → PA11</strong>, Operating Mode <strong>Normal</strong>, Baud Rate 500 kbit/s. Identical configuration applied to both Sender and Receiver projects ensures the two nodes agree on bit timing.</em>
</p>

<p align="center">
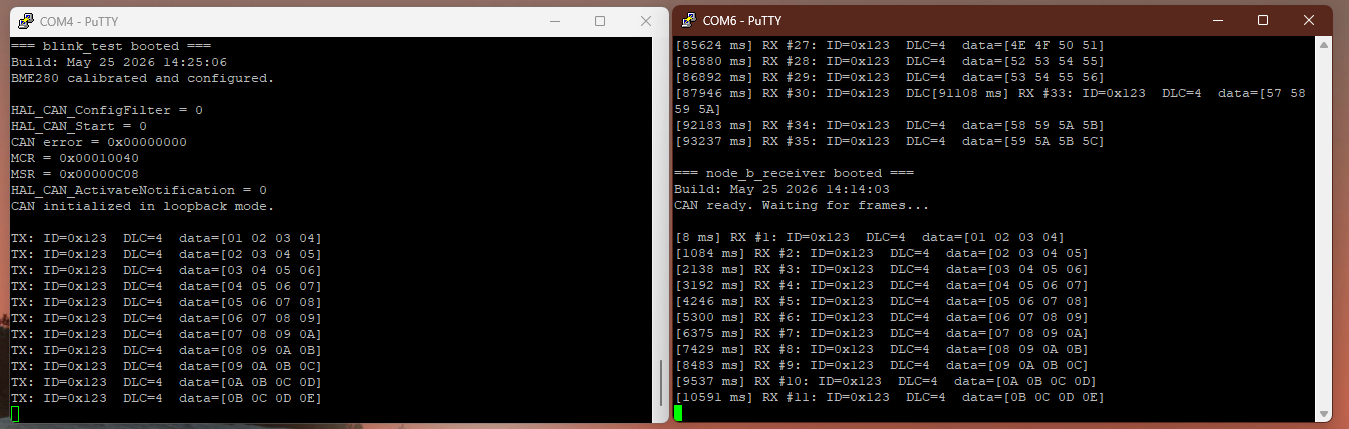
[picture p25: Project-Snaps/day08-two-board-can/02-putty-dual-tx-rx.png]
  
  <br>
  <em>Close-up of both PuTTY windows showing the full bring-up sequence: sender's init diagnostics (all <code>HAL_OK</code>, CAN error 0x00000000), then steady TX (left); receiver's independent boot, then sequential RX frames (right). Counter increments in lockstep on both sides.</em>
</p>

</details>

### Week 2 — Application-layer integrity, heartbeat, safe state, logging

#### Day 9 (2026-06-25) — Application-layer message integrity: counter, CRC-8, lost-frame detection

The first Week 2 milestone moves up the stack: from "bytes arrive on the bus" (Day 8) to "the receiver can trust those bytes." A real safety network must detect both **corruption** (bit errors the CAN CRC didn't catch at the application boundary) and **loss** (frames that never arrived at all). This day implements both, end to end across the two nodes.

**Frame format.** Node A's payload was redefined from the Day 8 placeholder into a structured 8-byte safety frame:

| Byte | Field | Notes |
|---|---|---|
| 0 | Rolling message counter | `uint8_t`, wraps at 256 |
| 1 | Temperature integer part | signed °C, from BME280 |
| 2 | Temperature fractional part | 0–99 (×100) |
| 3 | System state enum | 0 = NORMAL, 1 = WARNING, 2 = CRITICAL |
| 4–6 | Reserved | `0x00` — room for humidity/pressure later |
| 7 | CRC-8 | computed over bytes 0–6 |

**Sender (Node A).** Each 100 ms cycle reads the BME280, classifies the temperature into a state, packs the frame, computes the CRC over bytes 0–6, writes it into byte 7, and transmits. The rolling counter increments every frame and wraps naturally at 256 — no explicit modulo needed because `uint8_t` overflow does it for free.

**Receiver (Node B).** On each received frame the node:
1. **Validates the CRC** — recomputes CRC-8 over bytes 0–6 and compares against byte 7. A mismatch increments a `crcErr` counter and the frame is rejected before its contents are trusted.
2. **Detects lost frames** — compares the received counter against the expected next value. Any positive gap means frames went missing; the gap size is added to a `lost` counter and logged explicitly. The same `uint8_t` wrap arithmetic that drives the sender's counter also makes gap detection correct across the 255 → 0 boundary (e.g. expected 255, received 2 → gap of 3, correctly counting 255, 0, 1 as lost).
3. **Maintains running statistics** — `recv` / `lost` / `crcErr` totals printed on every frame, giving a live integrity dashboard over UART.

**CRC-8 choice.** Polynomial `0x07`, init `0x00`, no reflection, no final XOR — the CRC-8/SMBus variant used in SMBus PEC and many I2C sensors. The identical `crc8.c` / `crc8.h` implementation is compiled into **both** projects, so sender and receiver agree bit-for-bit; any divergence would surface immediately as a 100% CRC-failure rate.

**Result.** With both nodes running, every frame validates: `OK`, `crcErr = 0`, and `recv` climbs 1:1 with the sender's counter. The lost-frame logic also proved itself on a real gap — when the receiver attached mid-stream and missed two in-flight frames, it logged `>>> LOST 2 frame(s) (expected 144, got 146)` and bumped `lost` by exactly 2, then resumed clean tracking. This is the COM-like validation and DEM-like fault-counting behaviour the project set out to demonstrate, in plain HAL code.

<p align="center">
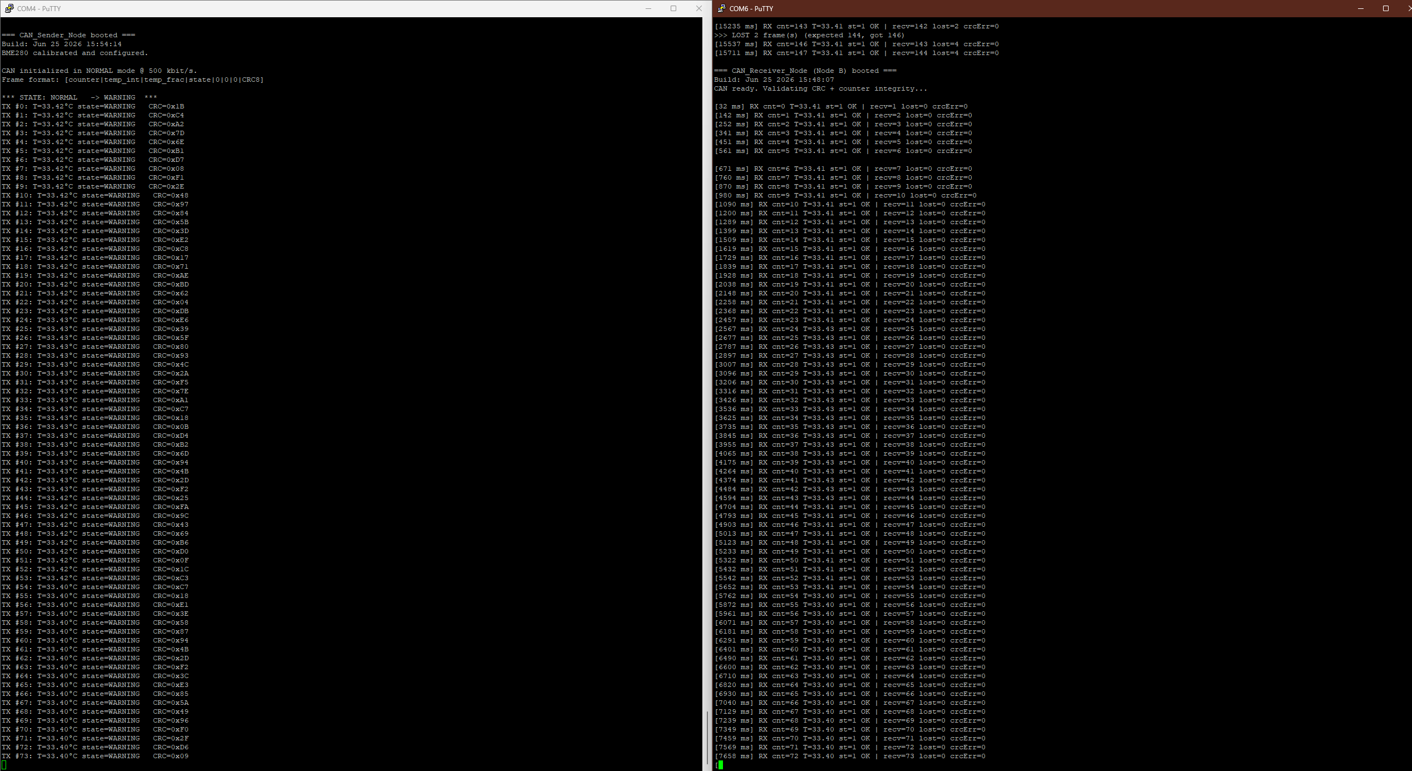
[picture p26: Project-Snaps/day09-integrity-crc/01-putty-dual-integrity-crc.png]
  
  <br>
  <em>Both PuTTY consoles during the integrity test. Left (COM4 — Node A): structured frames with live BME280 temperature, WARNING state, and per-frame CRC. Right (COM6 — Node B): every frame validated <code>OK</code> with <code>crcErr=0</code> and <code>recv</code> climbing in lockstep; near the top, the lost-frame detector fires on a real two-frame gap (<code>&gt;&gt;&gt; LOST 2 frame(s) (expected 144, got 146)</code>) and the <code>lost</code> counter increments accordingly.</em>
</p>

<details>
<summary>Shared CRC implementation across both nodes</summary>

<p align="center">
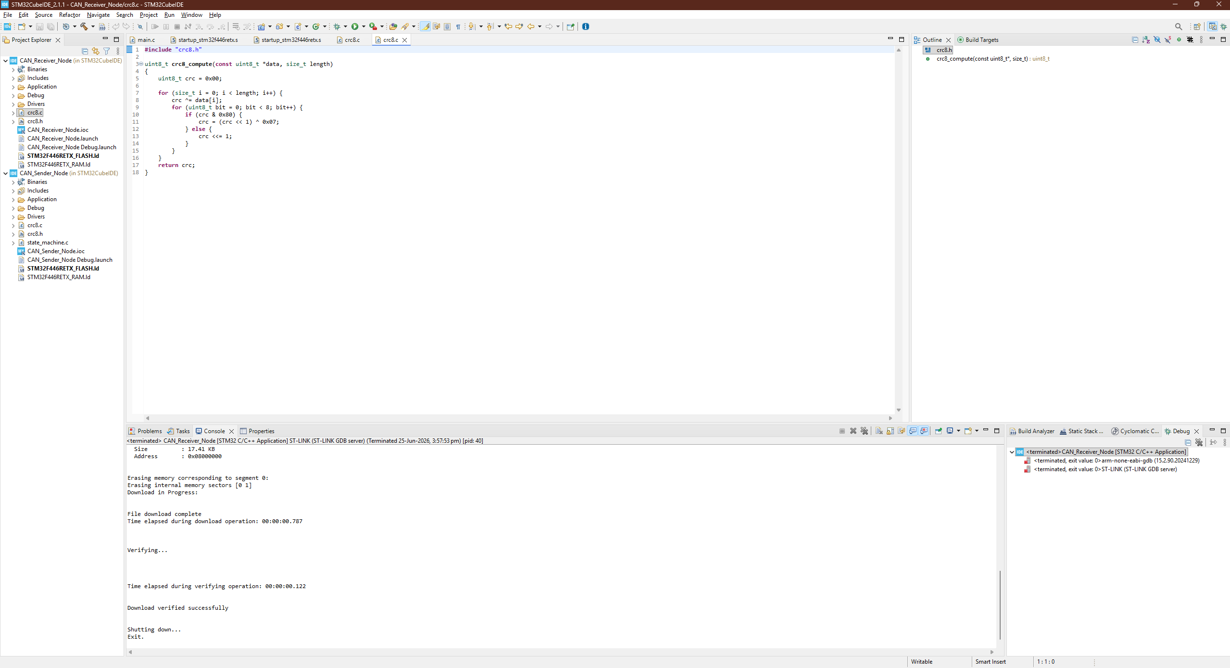
[picture p27: Project-Snaps/day09-integrity-crc/02-cubeide-crc8-both-nodes.png]
  
  <br>
  <em>CubeIDE workspace with both projects (<code>CAN_Receiver_Node</code> and <code>CAN_Sender_Node</code>) showing the shared <code>crc8.c</code> open — the same bit-serial CRC-8 (poly 0x07) compiled into each node. Console confirms a clean flash: download verified successfully.</em>
</p>

</details>

#### Day 10 (2026-06-26) — Heartbeat mechanism: independent liveness signal on a separate CAN ID

Message integrity (Day 9) proves that *the bytes you received* are trustworthy — but it cannot tell you that the *sender itself* is still alive. If Node A's firmware hangs or its power drops, no corrupt frame arrives; nothing arrives at all. A safety network needs a positive "I'm alive" signal, independent of the data path. That's the heartbeat — and it is the foundation for Day 11's safe-state watchdog.

**Two independent cadences via tick-based scheduling.** Node A's main loop was converted from a single `HAL_Delay(100)` blocking cycle to a non-blocking scheduler driven by `HAL_GetTick()`. Each frame type now fires on its own schedule, fully decoupled:

- **Sensor frame** (ID `0x123`, 8 bytes) every **100 ms**
- **Heartbeat frame** (ID `0x100`, 2 bytes: rolling counter + coarse uptime) every **200 ms**

The loop free-runs and checks `now - last_sensor_tx >= 100` and `now - last_heartbeat_tx >= 200` independently. This is the correct pattern for periodic messaging — a heartbeat that shares timing with the sensor loop is conceptually wrong, because the whole point is that it proves liveness regardless of what the data path is doing. It also sets up the bare-metal-vs-FreeRTOS comparison planned for Project 3, where this hand-rolled cooperative scheduler is replaced by real preemptive tasks.

**Receiver-side ID demultiplexing.** Node B's RX interrupt callback now branches on `rx_header.StdId`: heartbeat frames (`0x100`) land in a separate `hb_rx_data` buffer and raise `hb_rx_flag`; sensor frames (`0x123`) go through the existing Day 9 CRC/counter path. Copying into separate buffers inside the ISR prevents a heartbeat from clobbering a sensor frame mid-processing. The accept-all hardware filter (mask = 0) already passes both IDs to FIFO0, so no CubeMX change was needed — the demultiplexing is purely in software.

**Result.** Node A emits heartbeats on a clean 200 ms grid (`[HB #0 @ 200 ms]`, `[HB #1 @ 400 ms]`, …) interleaved with 100 ms sensor frames — roughly two sensor frames per heartbeat, exactly the expected ratio. Node B receives both streams without cross-contamination: CRC-validated sensor frames (`crcErr=0`) interleaved with `<HB #n recv @ ...>` lines, the heartbeat counter climbing 1:1 with no gaps and the `uptime_lo` field advancing. Node B now stores `last_hb_tick` on every heartbeat — the timestamp Day 11's timeout watchdog watches.

<p align="center">
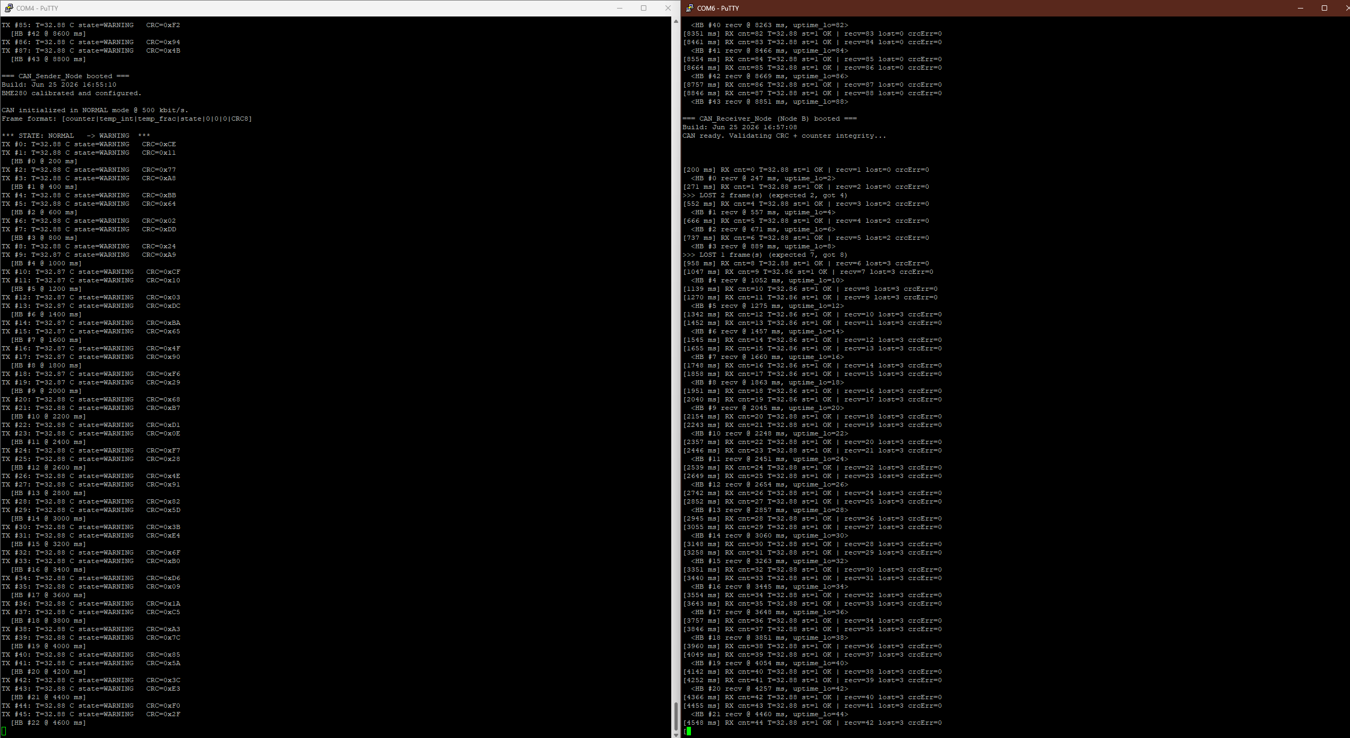
[picture p28: Project-Snaps/day10-heartbeat/01-putty-dual-heartbeat-cadence.png]
  
  <br>
  <em>Both consoles during heartbeat operation. Left (COM4 — Node A): sensor <code>TX</code> frames interleaved with <code>[HB #n @ ...ms]</code> on a clean 200 ms cadence. Right (COM6 — Node B): CRC-validated sensor <code>RX</code> lines interleaved with <code>&lt;HB #n recv @ ...&gt;</code> heartbeat lines; the heartbeat counter and <code>uptime_lo</code> field both climb cleanly, confirming the StdId demultiplexing works and the two cadences stay independent.</em>
</p>

#### Day 11 (2026-06-27) — Safe-state watchdog: heartbeat-timeout supervision and fail-safe actuation

Day 10 gave Node B a positive liveness signal; Day 11 makes it *act* on the absence of one. This is the core of the whole project — the transition from "a network that reports faults" to "a network that contains them." A real safety system must detect that the sender has gone silent and drive its outputs to a defined fail-safe condition within a bounded time, without human intervention. This day implements that supervision loop end to end: timeout detection, edge-triggered safe-state entry, fail-safe actuation, and automatic recovery.

**Heartbeat-timeout watchdog.** Node B continuously compares `HAL_GetTick() - last_hb_tick` against a 500 ms threshold. As long as heartbeats keep arriving (every 200 ms in normal operation), the elapsed time stays well under the limit. If the sender hangs, loses power, or the bus is severed, heartbeats stop, the elapsed time crosses 500 ms, and the watchdog trips. The 500 ms window is deliberately ~2.5× the 200 ms heartbeat period — long enough to tolerate a single missed or jittered beat, short enough to react promptly. In practice the trip fires at ~501–502 ms, the small overshoot being the main-loop granularity.

**Edge-triggered safe state.** Entry is guarded by an `in_safe_state` flag so the transition logic runs exactly once per fault, not every loop iteration. On the entry edge Node B drives the servo to its fail-safe position (simulating a cooling valve forced open), increments a `watchdog_trips` counter, and begins fast-blinking LD2 as a visible fault indicator. On recovery — the first heartbeat to arrive after the bus is restored — it prints a one-shot `RECOVERED` message and resumes normal state-tracking actuation. This edge-triggered structure is the same pattern AUTOSAR's WdgM uses for supervised-entity state transitions.

**Fail-safe actuation via PWM servo.** The servo is driven by `TIM3_CH1` on `PC6`, configured for 50 Hz (20 ms period) with the timer ticking at 1 µs (`PSC = 84-1`, `ARR = 20000-1`), so the compare register maps 1:1 to the servo's pulse width in microseconds. Operating states map to distinct angles — NORMAL ≈ 30°, WARNING ≈ 60°, CRITICAL ≈ 90° — and the fail-safe position is a separate, distinct angle so "safe" is never confused with a normal operating point. On boot the servo first homes to a 0° reference position and then ramps to NORMAL, establishing a known startup state.

**Startup grace period.** A freshly-booted Node B seeds `last_hb_tick` and suppresses safe-state entry for the first second (`WATCHDOG_GRACE_MS`), so the watchdog can't trip before the sender's first heartbeat has had a chance to arrive. This prevents a spurious safe-state entry at power-on.

**Result.** With both nodes running, disconnecting Node A produces the full supervised-fault cycle in one capture: heartbeats stop, the watchdog trips at **502 ms** (`*** SAFE STATE: heartbeat timeout (502 ms) — servo->SAFE, trips=1 ***`), the servo drives to fail-safe, and LD2 fast-blinks. When the bus is restored, the next heartbeat triggers `*** RECOVERED ***` and normal operation resumes. The counter-gap logic from Day 9 runs alongside the watchdog and independently reports the frames missed during the outage (`>>> LOST 19 frame(s)`), giving two complementary views of the same fault — the heartbeat watchdog for **liveness** and the rolling counter for **frame accounting**. Throughout the cycle the board stays alive and recovers cleanly.

<p align="center">
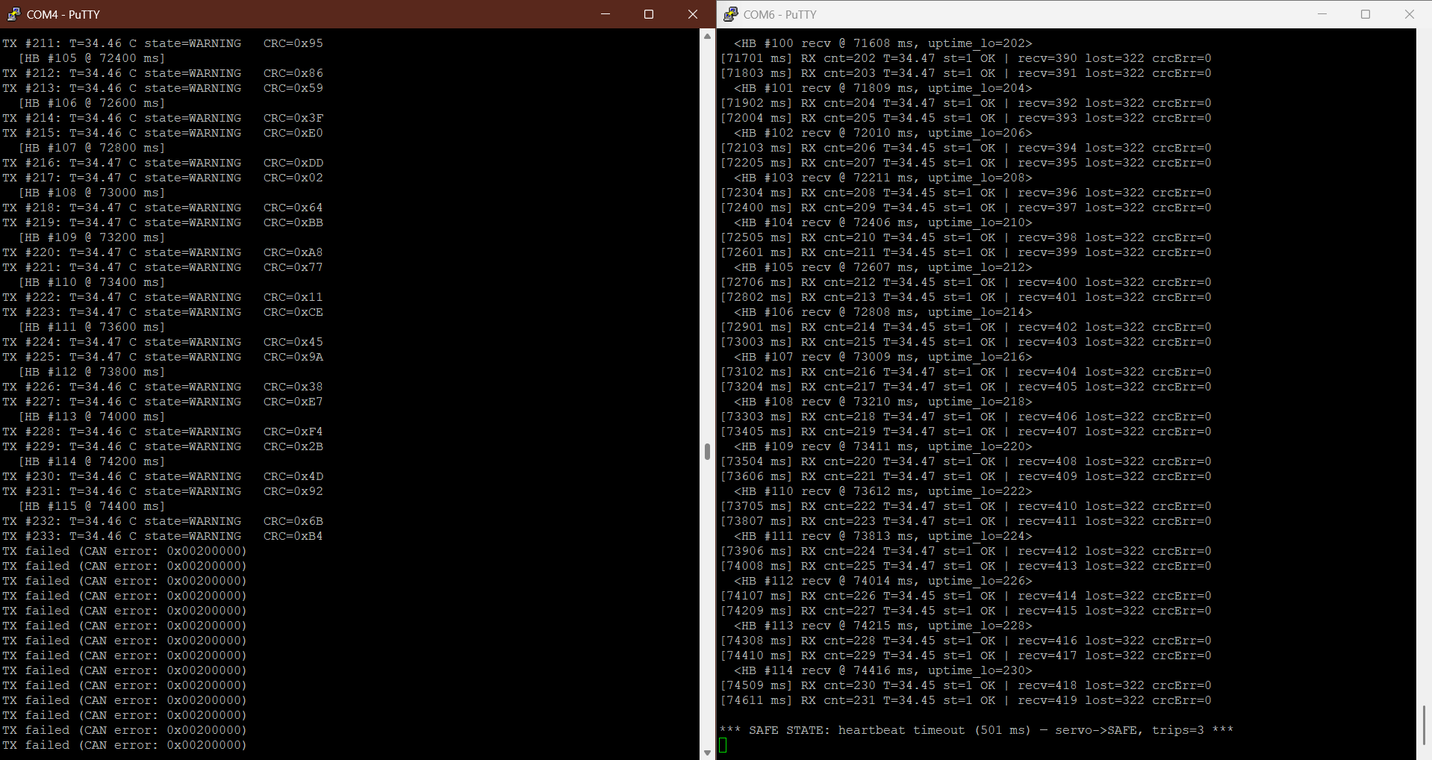
[picture p29: Project-Snaps/day11-safe-state/01-putty-safe-state-recovery-cycle.png]
  
  <br>
  <em>The complete supervised-fault cycle (COM6 — Node B). The heartbeat-timeout watchdog trips at 502 ms and drives the servo to its fail-safe position (<code>SAFE STATE … trips=1</code>); when the bus is restored the next heartbeat triggers <code>RECOVERED</code> and normal operation resumes. The Day 9 counter-gap detector runs alongside and independently reports the frames lost during the outage (<code>LOST 1</code>, then <code>LOST 19</code>) — liveness supervision and frame accounting working together.</em>
</p>

<p align="center">
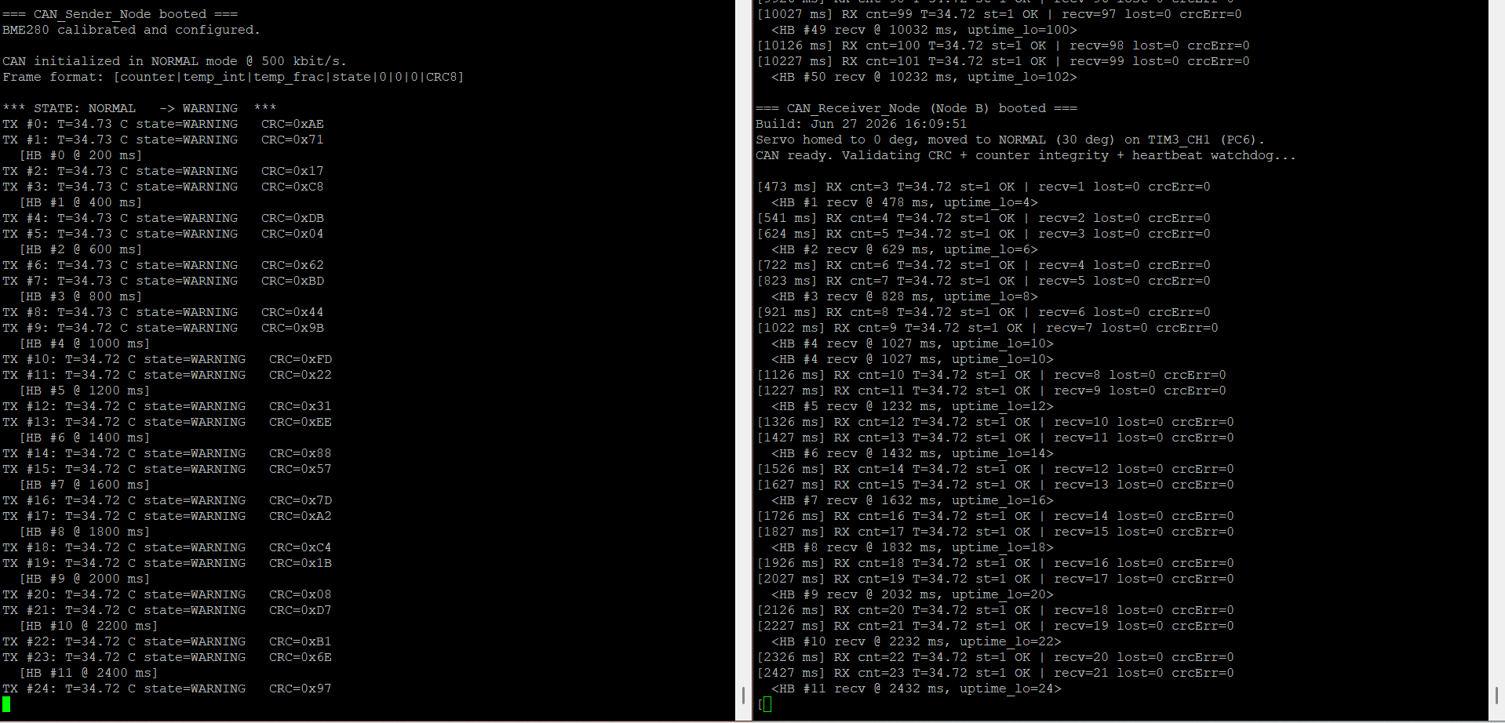
[picture p30: Project-Snaps/day11-safe-state/02-putty-boot-servo-home.png]
  
  <br>
  <em>Clean boot and startup sequence (COM6 — Node B). The build-provenance banner (<code>Build: Jun 27 2026 …</code>) confirms the running binary matches the current source, and <code>Servo homed to 0 deg, moved to NORMAL (30 deg) on TIM3_CH1 (PC6)</code> shows the boot homing behaviour before steady operation begins (<code>lost=0</code>, heartbeats on cadence).</em>
</p>

<p align="center">
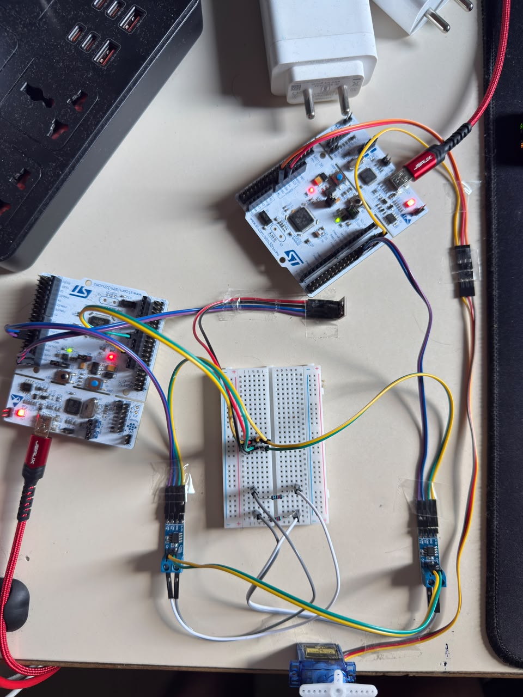
[picture p31: Project-Snaps/day11-safe-state/03-hardware-two-node-bus.png]
  
  <br>
  <em>The two-node safety network on the bench: both Nucleo-F446RE boards, the two SN65HVD230 transceivers and 120 Ω termination on the breadboard, the BME280 sensor, and the SG90 servo acting as the fail-safe actuator.</em>
</p>

<details>
<summary><strong>Servo PWM configuration (CubeMX — TIM3_CH1 on PC6)</strong></summary>

<p align="center">
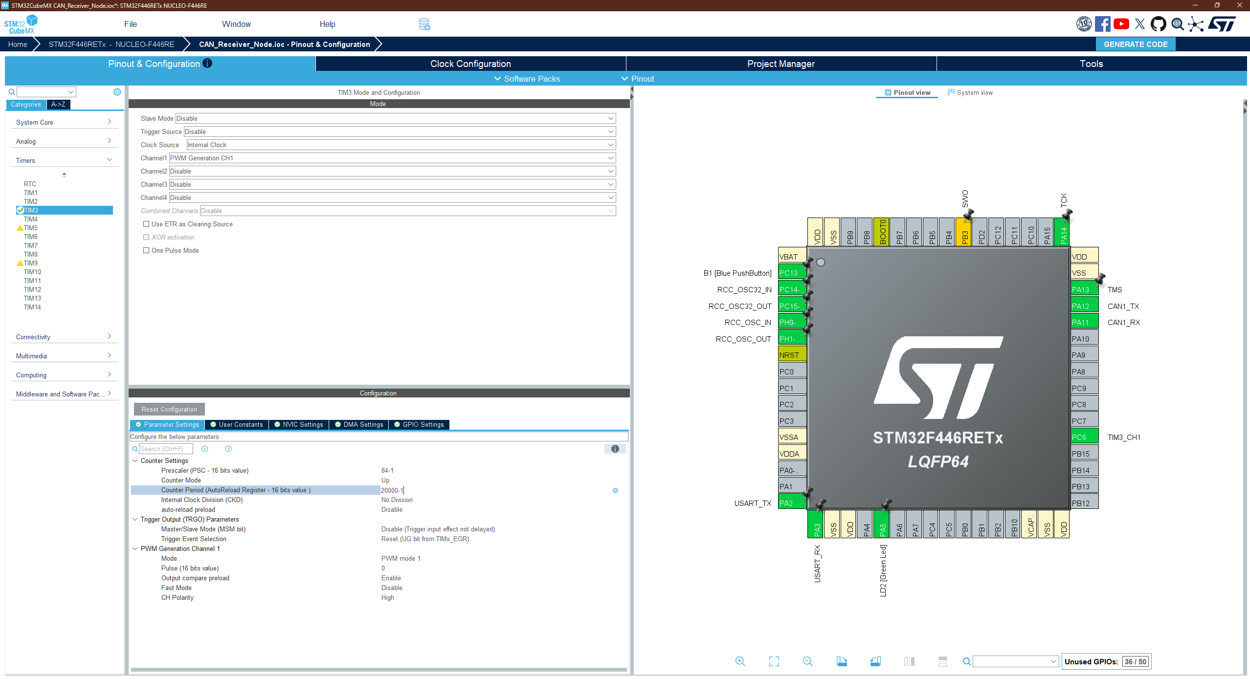
[picture p32: Project-Snaps/day11-safe-state/04-cubemx-tim3-pwm-servo.png]
  
  <br>
  <em>TIM3 configured for PWM generation on Channel 1, routed to <code>PC6</code>. Prescaler <code>84-1</code> gives a 1 µs timer tick from the 84 MHz APB1 timer clock; counter period <code>20000-1</code> yields a 20 ms (50 Hz) frame — standard hobby-servo timing — so the compare register equals the pulse width in microseconds.</em>
</p>

</details>

> **Hardware note — actuator power.** The SG90 is powered from the Nucleo's USB-fed 5 V rail, which cannot source the servo's stall current through its full travel: large moves brown out the MCU and reset the board. Two measures keep the demonstration stable on this shared supply — servo movements are **rate-limited** (the target is approached in small stepped increments rather than a single commanded swing, bounding inrush current), and the fail-safe angle is **capped** at the largest position the rail can drive reliably. The PWM commands the full range correctly; the servo simply stalls partway under the sagging rail. In a production design the actuator would run from a **dedicated 5 V supply with a common ground** to the controller — the standard practice for isolating an inductive load's current transients from the MCU. This is the engineering reason actuator power is separated from controller power, demonstrated here as a real constraint rather than hidden.

#### Day 12 (2026-06-27) — Fault injection on real hardware: logic-analyzer bus capture and the three-layer evidence chain

The watchdog of Day 11 was validated by disconnecting the bus and reading the result on a console. Day 12 instruments the fault at the **physical layer** — capturing the actual CAN bitstream on the wire with a logic analyzer — so the fault and the firmware's reaction to it can be observed simultaneously across three independent layers of the system. This is the difference between *claiming* the safety mechanism works and *showing* the full causal chain from a severed wire to a safe output.

**Probing the logic-level CAN signal.** A standard 8-channel logic analyzer cannot read `CAN_H`/`CAN_L` directly — those are differential analog lines. Instead the analyzer's `D0` channel is clipped to the **TXD pin of Node A's SN65HVD230 transceiver** (the logic-level side, electrically the same signal as the STM32's `CAN1_TX`/`PA12`), with a common ground reference. This is the clean 0/3.3 V digital bitstream that the protocol decoder can turn into frames. Capture runs in PulseView (sigrok) at 1 MHz — 2× oversampling on the 500 kbit/s bus, the highest rate the analyzer sustains reliably — with the built-in CAN decoder set to a 500000 nominal bitrate.

**Bit-accurate frame decode.** With the probe in place the decoder reconstructs every field of the live traffic: start-of-frame, identifier `0x123`, DLC 8, all eight data bytes, the CAN protocol's own CRC-15, ACK slot, and end-of-frame. Crucially the decoded data bytes match the firmware's frame format exactly — the rolling counter, the temperature integer/fraction, the state enum, and the application-layer CRC-8 in byte 7 — independently confirming the entire transmit path at the bit level.

**The fault and its three-layer evidence.** Pulling the CAN bus wire mid-stream severs the network, and the consequence appears at three layers at once:

1. **Physical (logic analyzer).** The decoded frame stream stops dead — `D0` goes idle and the CAN decoder produces no further valid frames. The capture shows steady framing on the left, then silence at the disconnect. This is the *cause*, visible on the wire.
2. **Transmitter (Node A, COM4).** Node A's transmissions immediately begin failing with `TX failed (CAN error: 0x00200000)` — `HAL_CAN_ERROR_NACK`. With the bus broken, no node can acknowledge, so every frame NACKs. This is the fault propagating up to the sender.
3. **Application (Node B, COM6).** ~500 ms later the heartbeat-timeout watchdog fires — `*** SAFE STATE: heartbeat timeout (501 ms) — servo->SAFE, trips=3 ***` — and Node B drives the servo to its fail-safe position. This is the fault *detected and contained*.

**A note on the two detection mechanisms.** During total bus loss the counter-gap detector freezes (`lost` stops advancing) because gap detection needs *incoming* frames to measure gaps against — with the sender fully silent, there are none. The fault is instead caught by the heartbeat watchdog, which detects *absence*. This is exactly why the two mechanisms are complementary: counter gaps catch **partial** loss (some frames missing from an otherwise live stream), the heartbeat watchdog catches **total** loss (the stream stopping entirely). Neither alone is sufficient; together they cover the full fault space.

<p align="center">
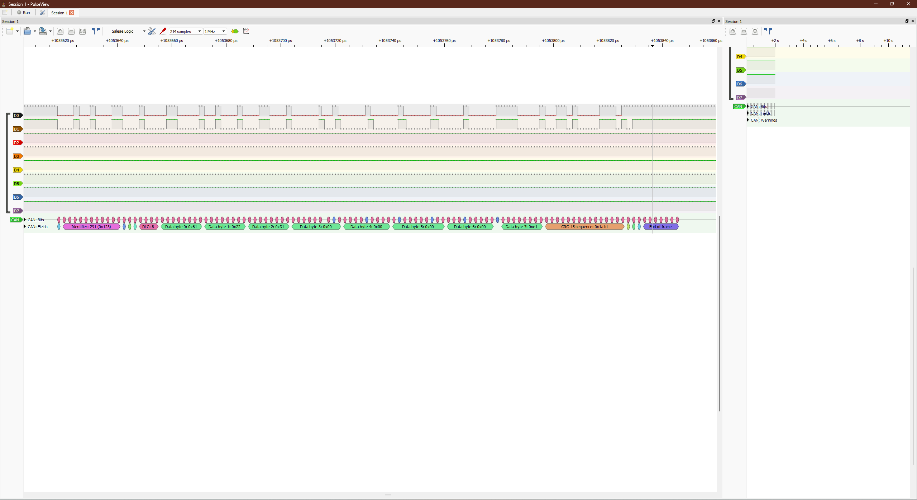
[picture p33: Project-Snaps/day12-fault-injection/01-pulseview-can-decode.png]
  
  <br>
  <em>PulseView decoding the live CAN bitstream on <code>D0</code> (Node A transceiver TXD). The CAN decoder reconstructs the full frame: <code>Identifier: 291 (0x123)</code>, <code>DLC: 8</code>, all eight data bytes, the protocol-level <code>CRC-15</code>, and <code>End of frame</code>. The decoded data bytes match the firmware's frame format exactly — verifying the transmit path at the bit level.</em>
</p>

<p align="center">
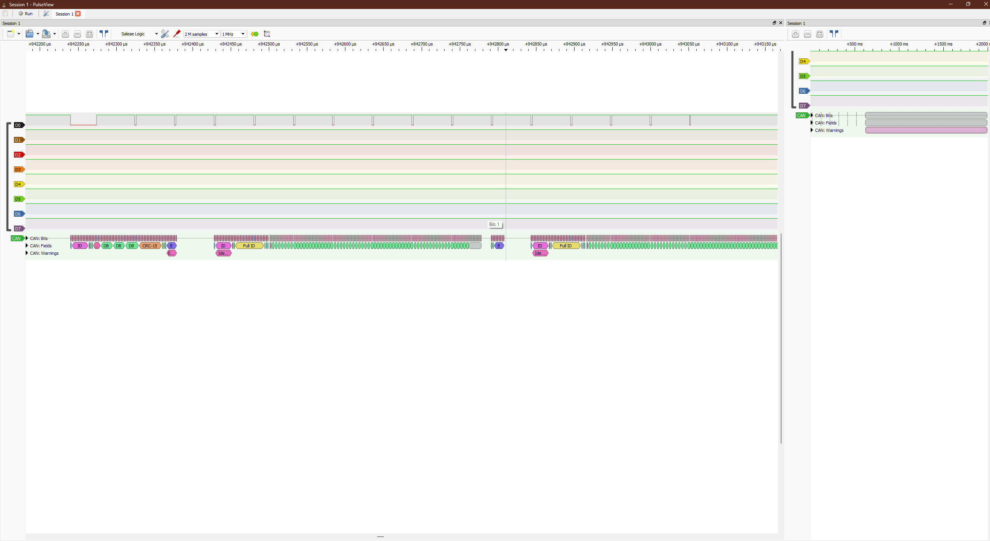
[picture p34: Project-Snaps/day12-fault-injection/02-pulseview-bus-silence.png]
  
  <br>
  <em>The fault at the physical layer: steady decoded frames on the left, then the bus goes silent at the moment the wire is pulled. The decoder can no longer form valid frames — the bitstream simply stops. This is the <em>cause</em> of the fault, captured on the wire.</em>
</p>

<p align="center">
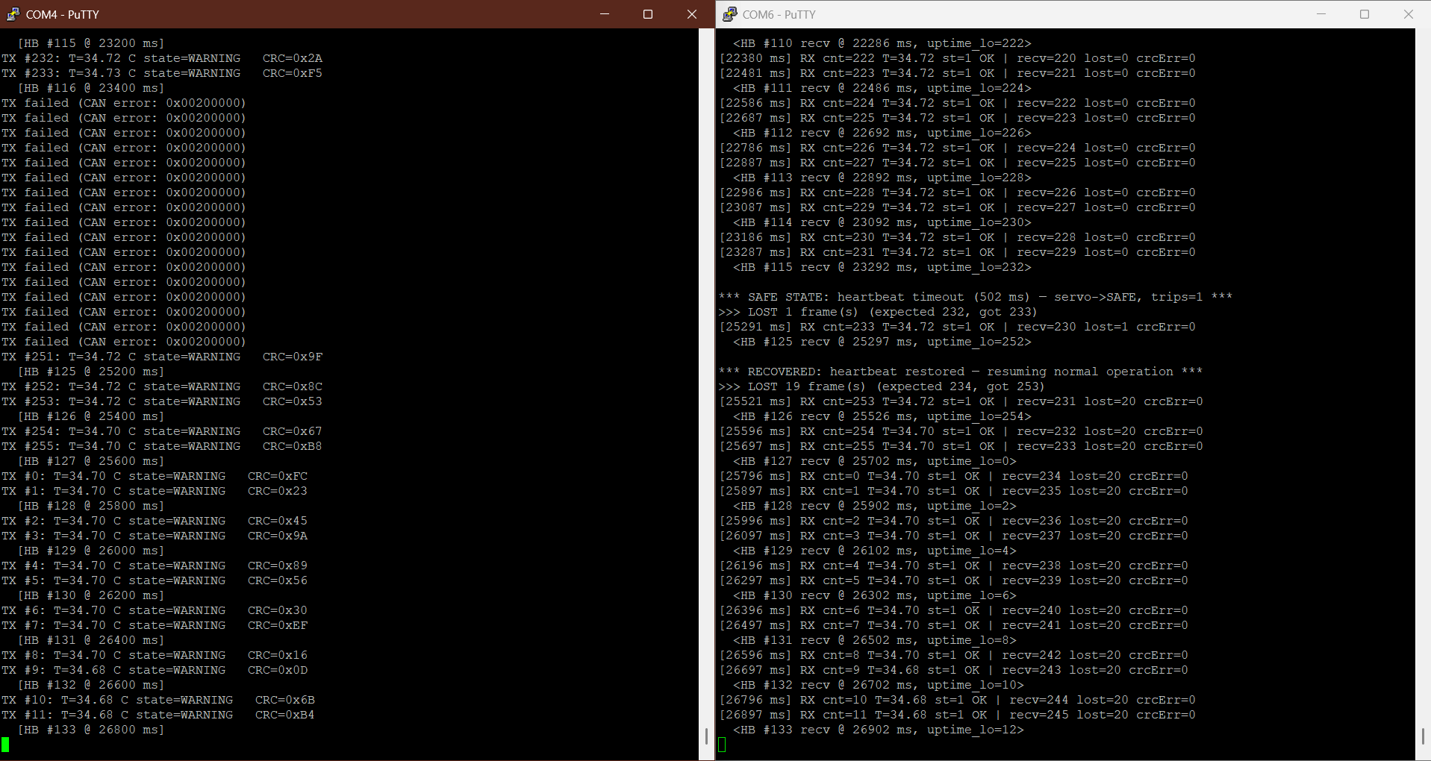
[picture p35: Project-Snaps/day12-fault-injection/03-fault-injection-safe-state.png]
  
  <br>
  <em>The fault at the transmitter and application layers, simultaneously. Left (COM4 — Node A): transmissions fail with <code>CAN error: 0x00200000</code> (NACK) the instant the bus is severed — nothing can acknowledge. Right (COM6 — Node B): the heartbeat watchdog fires <code>*** SAFE STATE: heartbeat timeout (501 ms) — servo-&gt;SAFE ***</code> and drives the servo to fail-safe. Cause, propagation, and containment in one capture.</em>
</p>

<details>
<summary><strong>Fault-injection hardware setup (logic analyzer tapping the bus)</strong></summary>

<p align="center">
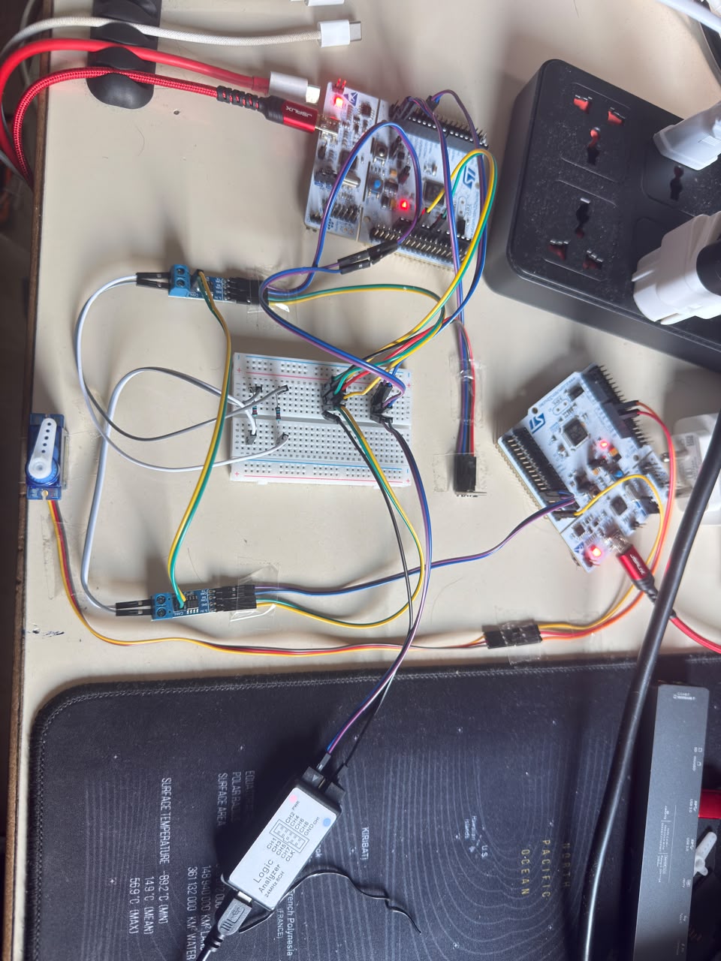
[picture p36: Project-Snaps/day12-fault-injection/04-hardware-full-setup-with-analyzer.png]
  
  <br>
  <em>The full bench during fault injection: both Nucleo-F446RE nodes, the two SN65HVD230 transceivers with 120 Ω termination, the BME280 and SG90 servo, and the 8-channel logic analyzer (bottom) with its probe clipped to Node A's transceiver TXD line and a common ground, USB-connected to the PulseView host.</em>
</p>

</details>

#### Day 13 (2026-07-02) — Python CAN logger: an independent third observer of the bus

Days 9–12 built integrity and supervision *inside* the network — the receiver validates what the transmitter sends, and a logic analyzer confirms it at the bit level. Day 13 adds a fourth perspective from *outside* the two nodes: a PC-side Python logger that taps the live bus, decodes every frame in real time, and **independently re-implements the same integrity checks** the STM32 receiver performs. When the transmitter, the receiver, and an independently-written PC observer all agree on counter continuity and CRC validity, a single shared bug can no longer hide the truth — that cross-check is the point.

**Passive tap via listen-only mode.** The Innomaker USB2CAN adapter joins the bus as a *third node*, driven directly through the `gs_usb` library in **listen-only mode** — it receives frames without ever ACKing or transmitting, so it cannot disturb the two-node network it is measuring. This is the correct posture for an analysis tool: an observer that perturbs the system it observes is worthless. (An earlier attempt in normal mode had the adapter actively ACKing, which collided with the real traffic and pushed Node B's loss rate to ~24% — the visible symptom that a logger must stay passive.)

**Independent decode and re-validation.** `can_logger.py` parses both frame types — the `0x123` sensor frame (counter, temperature, state enum, application CRC-8) and the `0x100` heartbeat (counter + coarse uptime). For every sensor frame it **recomputes the CRC-8** (poly `0x07`) in Python and **re-derives counter gaps** (`(counter - last - 1) & 0xFF`), entirely independently of Node B's firmware. The 8-bit wrap arithmetic matches the sender's, so a legitimate 255→0 rollover correctly yields a gap of zero rather than a false alarm. Output streams live to the console and to a timestamped CSV.

**Two-stage pipeline.** Following the same capture-then-report structure as Project 1, logging and analysis are separated: `can_logger.py` writes the CSV live; `can_report.py` reads it offline and produces a four-panel matplotlib report — temperature over time, heartbeat-interval histogram (clustered on the 200 ms target), sensor inter-frame timing, and a counter timeline with fault markers. Keeping the raw CSV independent of the plotting means a capture is never lost to a downstream error, and different reports can be regenerated from the same run without touching hardware.

**Result — clean baseline.** With both nodes running normally, the logger confirms the network from its independent vantage point: the counter advances by exactly 1 every frame, `crc=OK` throughout, `lost=0`, heartbeats on a tight ~200 ms grid and sensor frames on ~100 ms. Three observers — transmitter, receiver, PC — in full agreement.

<p align="center">
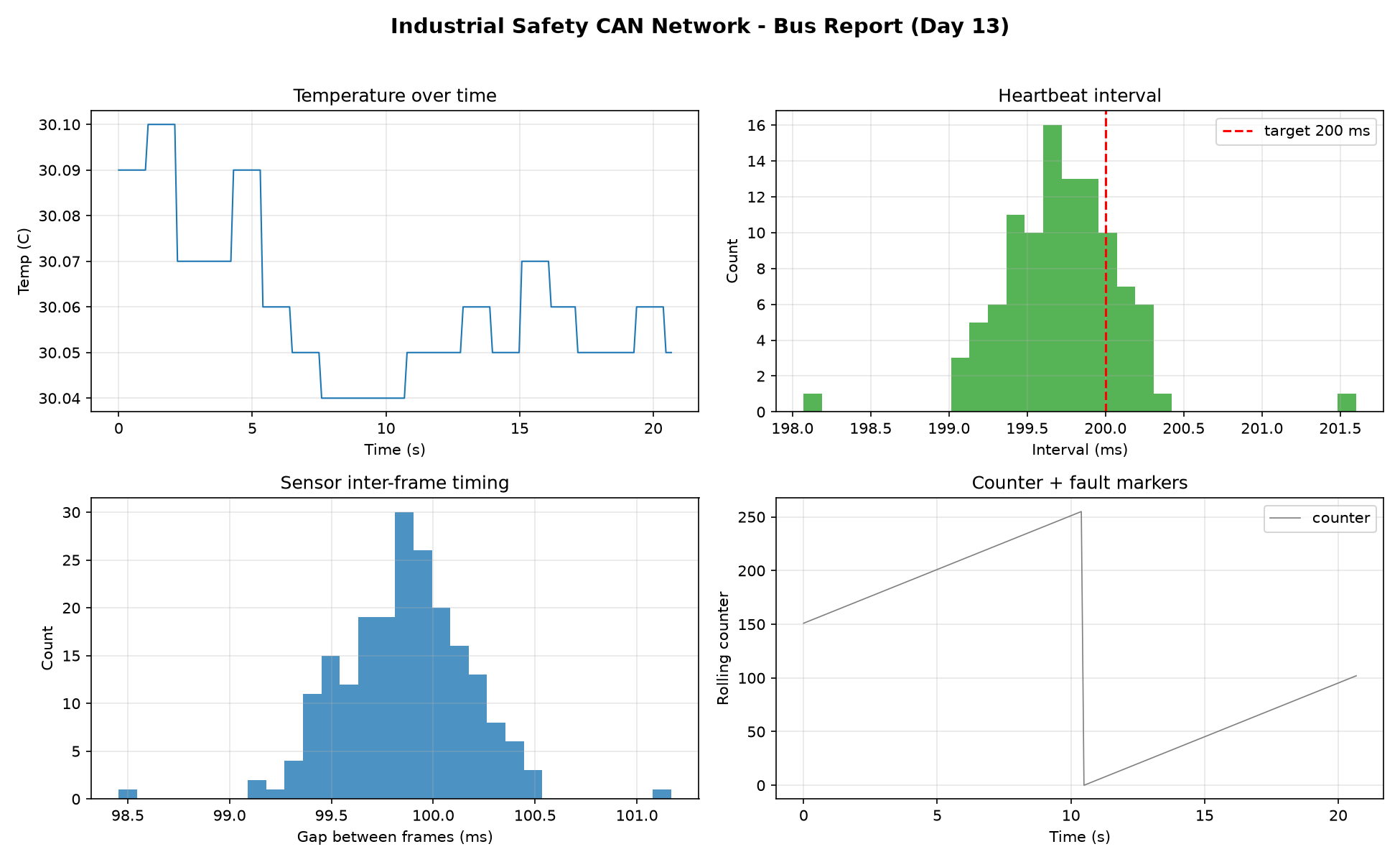
[picture p37: Project-Snaps/day13-python-logger/can_report_baseline.png]
  
  <br>
  <em>Four-panel bus report from a clean run (33 s, 333 sensor frames, 166 heartbeats). Heartbeat intervals cluster tightly on the 200 ms target and sensor spacing on 100 ms; the counter timeline is an unbroken sawtooth (the single vertical step is a legitimate 255→0 rollover, correctly reported as zero loss) with no fault markers. <code>lost=0</code>, <code>crcErr=0</code>.</em>
</p>

**Result — fault injection from a third angle.** Repeating the Day 11/12 disconnect while the logger runs, the bus goes silent for ~4 s; on reconnection the logger flags a single counter gap (~37 frames — those Node A transmitted into the dead bus) and localises the loss to exactly the disconnect window, with every surviving frame still `crc=OK`. This is the *same fault* already caught by Node B's heartbeat watchdog and the Day 12 logic-analyzer trace — now confirmed a third time, in independently-written PC code. The complementary-detection theme from Day 12 holds here too: total silence produces one clean gap at the boundary, not a stream of partial losses.

<p align="center">
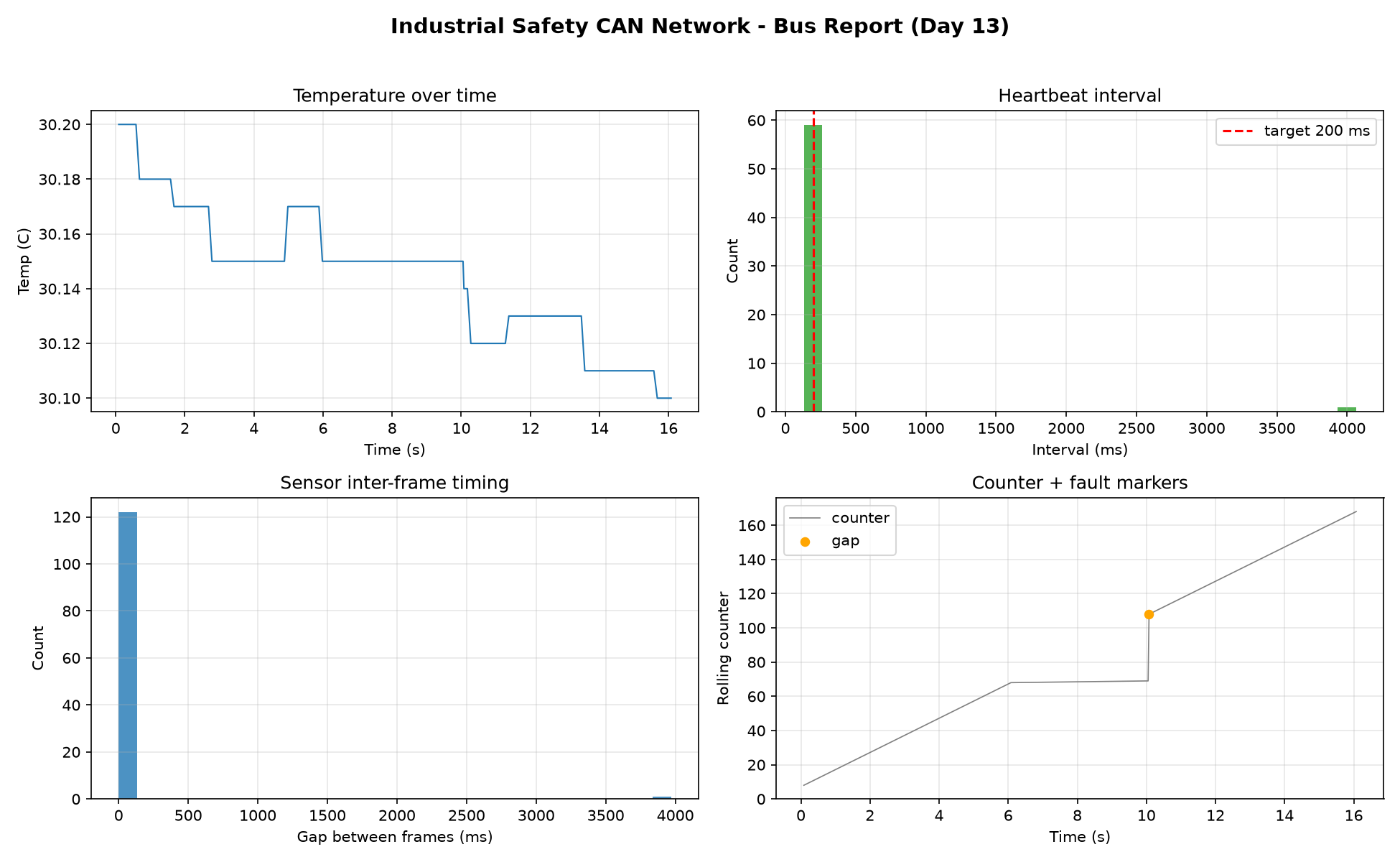
[picture p38: Project-Snaps/day13-python-logger/can_report_fault.png]
  
  <br>
  <em>Fault-injection capture. The bus is severed mid-stream: the heartbeat-interval and inter-frame-timing panels each show a single ~4 s outlier, and the counter timeline steps up once at reconnection with a lone orange gap marker — the frames lost during the outage. Loss is confined to the disconnect; no corruption elsewhere.</em>
</p>

<details>
<summary><strong>Bringing up the adapter — the debugging chain that made it work</strong></summary>

Getting a clean capture on Windows with a low-cost gs_usb adapter took a sequence of physical- and driver-layer fixes, each worth recording:

- **Driver binding.** The adapter needs a libusb-class driver bound via Zadig (`libusbK`), plus a libusb backend for `pyusb` — `WinUSB` alone produced `[Errno 13] Access denied` on device claim.
- **Sample point, not just bitrate.** Frames initially decoded as a garbled `0x00C` at ~1/15 the expected rate. Root cause was a **sample-point** mismatch: matching the 500 kbit/s bitrate is insufficient — the adapter (48 MHz clock) and the STM32 (42 MHz APB1, prescaler 6 / BS1 11 / BS2 2 → 75% sample point) must agree on *where in the bit* they sample.
- **Termination at a passive tap.** The decisive fix. In normal mode the adapter's own transceiver drove the bus hard enough to *mask* a marginal tap (yielding corrupted frames); switching to listen-only removed that drive and exposed the real problem — with no proper termination at the tap point the receiver saw nothing. Restoring a clean ~60 Ω bus (adapter's onboard 120 Ω enabled, one node-end resistor lifted), short stubs, and all three lines (CAN_H, CAN_L, GND) solidly connected produced clean frames. *Normal mode can hide a bad tap by brute force; listen-only is the honest test of physical-layer integrity.*
- **RX FIFO drain on startup.** The adapter can hold a stale frame from before capture begins; if it becomes the counter baseline, the first real frame reports a phantom gap. The logger now drains the FIFO before its main loop so only live frames enter the log.
</details>

<details>
<summary><strong>Known limitation — reboot vs. mass loss (a firmware follow-up)</strong></summary>

The logger cannot currently distinguish a Node A **reboot** from **mass frame loss**: a reboot resets the rolling counter toward zero, which looks identical to a large gap. The obvious disambiguator — the heartbeat's uptime — is a single byte (`(tick/100) mod 256`) that wraps every 25.6 s, and the heartbeat counter wraps every 51.2 s, so at those wrap points a healthy node momentarily *looks* reset. Any heuristic built on those two bytes would raise periodic false "reset" alarms. The correct fix is a dedicated **boot-counter** in one of the frame's reserved bytes (4–6), incremented only on power-on — making a reboot unambiguous. Documented here as a deliberate design note rather than papered over with a fragile timing hack.
</details>

## Skills demonstrated

### Embedded C
- Bitmasks and bitwise operators (`<<`, `^=`, `|=`, `&= ~`); `volatile` keyword for memory-mapped I/O
- `enum` / `typedef` discipline for self-documenting state types
- Modular architecture: separation into hardware drivers (`bme280.*`), state policy (`state_machine.*`), and application orchestration (`main.c`)
- Syscall retargeting (`_write`) to redirect `printf` to UART
- Fixed-point compensation math: `int32_t` / `int64_t` arithmetic per Bosch datasheet specification
- Unsigned integer wrap arithmetic for rolling counters and gap detection (`uint8_t` overflow as intentional modulo-256)

### STM32 / HAL
- HAL programming — GPIO, UART, I2C, CAN
- CMSIS register-level access (`BSRR`, `ODR`) — atomic vs read-modify-write
- STM32CubeMX → STM32CubeIDE workflow with peripheral-per-file code generation
- `.ioc` regeneration discipline — adding peripherals mid-project (I2C on Day 3) without losing user code
- Non-blocking cooperative scheduling via `HAL_GetTick()` — replacing blocking `HAL_Delay()` to run independent periodic tasks at different rates
- Timer PWM generation: `TIM3_CH1` at 50 Hz with a 1 µs tick (`PSC`/`ARR` chosen so the compare register maps directly to pulse width in µs)

### Communication protocols
- I2C bus: 7-bit addressing, master-slave model, bus scanning, register-based sensor protocols
- UART (115200 8N1): serial debugging via ST-Link virtual COM port
- CAN bus protocol: 11-bit standard frame format, mailbox-based TX, FIFO-based RX, hardware filtering (ID/mask), bit timing configuration
- CAN loopback mode for peripheral validation without external bus
- CAN Normal mode operation: differential signaling over CANH/CANL, ACK-based frame validation, multi-node bus
- CAN bus termination: 120 Ω resistors to match characteristic impedance and prevent signal reflections
- Bit-timing matching across nodes (Prescaler, BS1, BS2) at 500 kbit/s
- Multi-ID CAN messaging: separate message IDs for data (0x123) and liveness/heartbeat (0x100) on one bus
- Receiver-side ID demultiplexing — branching on StdId in the RX ISR to route frames into separate buffers
- Protocol decoding from raw signals: reconstructing CAN frames (ID, DLC, data, CRC-15, ACK, EOF) from a captured logic-level bitstream with a software decoder
- CAN sample-point matching (not just bitrate) across heterogeneous clocks — diagnosing mis-decoded frames caused by differing sample points between a 48 MHz adapter and a 42 MHz STM32
- Bus termination for a passive analysis tap — recognising that a listen-only node still requires correct termination, and that normal-mode driving can mask a marginal physical connection

### Safety and integrity
- Application-layer message integrity: CRC-8 (poly 0x07) over a structured payload, computed and validated independently of the CAN protocol's own CRC
- Rolling message counter with receiver-side gap detection for lost/duplicate-frame identification
- Running fault statistics (received / lost / CRC-error counts) — a live integrity dashboard, the basis for AUTOSAR DEM-style fault qualification
- Shared integrity code compiled identically into multiple nodes to guarantee agreement
- Heartbeat / liveness signalling — independent periodic "I'm alive" message decoupled from the data path, the basis for watchdog supervision
- Heartbeat-timeout watchdog: bounded-time detection of sender silence (500 ms threshold ≈ 2.5× the heartbeat period) — AUTOSAR WdgM-style alive supervision
- Edge-triggered safe-state entry with a trip counter and visible fault indication, plus automatic recovery on heartbeat restoration
- Fail-safe actuator design: a distinct, defined safe position separate from all normal operating angles
- Startup grace period to suppress spurious safe-state entry before the first heartbeat arrives
- Complementary fault detection: heartbeat watchdog (liveness) and rolling-counter gaps (frame accounting) catching the same fault from two angles
- Requirements-driven development: explicit requirements specification with verification methods and a one-page ISO 26262-style HARA deriving safety goals from identified hazards

### Sensor integration
- BME280 wiring (I2C + 3.3V power), chip ID verification pattern
- Factory calibration data handling (compensation coefficients stored in non-volatile chip memory)
- Float-formatted `printf` output via `-u _printf_float` linker flag
- PWM actuator control with rate-limited movement to bound inrush current on a shared power rail
- Power-integrity awareness: diagnosing servo-induced brown-out (rail sag → MCU reset) and mitigating via rate limiting and load-appropriate set-points; recognising dedicated actuator supply + common ground as the production fix

### Embedded design patterns
- State-machine design: threshold classification, edge-triggered transition detection (the foundational pattern for CAN event emission and AUTOSAR DEM-style fault logging)
- Hysteresis: asymmetric rising/falling thresholds to prevent state flapping near boundaries (industrial controller standard practice)
- HAL weak-symbol callbacks (`HAL_CAN_RxFifo0MsgPendingCallback`) — overriding default empty implementations to handle peripheral events
- ISR-to-main-loop communication via `volatile` flag variables (mandatory to prevent compiler caching)
- Multi-project firmware design: separate CubeIDE projects for distinct nodes, each with its own peripheral configuration and main loop

### Debugging and measurement
- Live UART logging during execution; timing measurement via `HAL_GetTick()`
- Quantitative analysis of blocking I/O overhead (printf cost ≈ 2–3 ms at 115200 baud)
- Diagnostic instrumentation via `HAL_CAN_GetError()` and register inspection (MCR/MSR) when peripheral init failed silently
- Build-provenance verification via `__DATE__`/`__TIME__` boot banner — catching stale-flash mismatches between source and the binary actually running on the board
- Board-specific pin discovery — verifying datasheet pinout claims against actual Nucleo header accessibility
- Dual-PuTTY workflow for two-node embedded systems: independent ST-Link VCP enumeration (COM4 + COM6) for simultaneous TX/RX observation
- Logic-analyzer capture (PulseView/sigrok): probe setup, sample-rate selection for a given bit rate, protocol-decoder configuration (CAN at 500 kbit/s)
- Physical-layer debugging: probing the transceiver's logic-level TXD line (not the differential CAN_H/CAN_L) to obtain a decodable digital signal
- Hardware fault-injection testing: deliberately severing the bus mid-stream and capturing the consequence across physical, transmitter, and application layers simultaneously
- Multi-layer evidence correlation: lining up a logic-analyzer trace, transmitter NACK errors, and application-level safe-state entry to prove a complete fault-to-containment chain
- PC-side CAN capture bring-up: gs_usb adapter driver binding, listen-only configuration, stale-FIFO draining, and correlating an independent Python decode against the embedded receiver's own statistics

### Python / PC-side tooling
- CAN bus monitoring in Python via `gs_usb` direct device control (listen-only mode) — a passive third-node observer that does not perturb the network under test
- Independent re-implementation of application-layer integrity (CRC-8 recompute, counter-gap detection) on a different platform to cross-check the embedded receiver
- Real-time frame decode and timestamped CSV logging; offline matplotlib reporting (capture-then-report pipeline)
- USB/driver bring-up on Windows: Zadig driver binding (libusbK), libusb backend for pyusb, RX-FIFO management

## Project achievements

This project demonstrates, end to end on real hardware:

- Two-node STM32 CAN communication at 500 kbit/s
- Modular embedded C architecture (drivers / policy / orchestration)
- Application-layer CRC-8 integrity, independent of the CAN protocol CRC
- Rolling message counters with lost-frame detection
- Independent heartbeat liveness supervision
- Heartbeat-timeout watchdog with deterministic safe-state transition (~501 ms)
- Servo fail-safe actuation with a defined safe position, honest power-integrity handling
- Physical-layer verification with a logic analyzer (three-layer fault evidence)
- An independent Python CAN logger (listen-only) cross-checking the receiver
- Requirements-driven development with explicit REQ-IDs and verification
- A one-page ISO 26262-inspired HARA deriving safety goals from hazards

## Author

Swayam Jakhalekar — M.Sc. Control, Computer and Communications Engineering
Technische Hochschule Mittelhessen, Friedberg
