chenyurong22/industrial-safety-can/CAN_Receiver_Node/Core/Src/main.c

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
/* Includes ------------------------------------------------------------------*/
#include "main.h"

/* USER CODE BEGIN Includes */
#include <stdio.h>
#include "crc8.h"
/* USER CODE END Includes */

CAN_HandleTypeDef hcan1;

TIM_HandleTypeDef htim3;

UART_HandleTypeDef huart2;

/* USER CODE BEGIN PV */
CAN_RxHeaderTypeDef rx_header;
uint8_t rx_data[8] = {0};
volatile uint8_t can_rx_flag = 0;

/* Day 9 integrity tracking */
static uint8_t  expected_counter = 0;
static uint8_t  first_frame      = 1;
uint32_t rx_received   = 0;
uint32_t rx_lost       = 0;
uint32_t rx_crc_errors = 0;

/* Heartbeat tracking */
volatile uint8_t hb_rx_flag = 0;
uint8_t  hb_rx_data[2] = {0};
uint32_t hb_count = 0;
uint32_t last_hb_tick = 0;

/* Servo PWM pulse widths (µs) — TIM3_CH1 CCR maps 1:1 to microseconds */
#define SERVO_HOME      1000   /* 0°   — boot reference/home position */
#define SERVO_NORMAL    1167   /* 30°  */
#define SERVO_WARNING   1333   /* 60°  */
#define SERVO_CRITICAL  1500   /* 90°  */
#define SERVO_SAFE      2000   /* 180° — fail-safe full-open */

/* Rate-limited movement: step size and delay bound inrush current so the
   SG90 can run off the Nucleo 5V rail without browning out the board. */
#define SERVO_STEP_US      20   /* µs of pulse change per step  */
#define SERVO_STEP_DELAY    5   /* ms between steps             */

static uint16_t servo_current_us = SERVO_HOME;  /* tracks last commanded position */

/* Safe-state / watchdog tracking */
#define HEARTBEAT_TIMEOUT_MS  500
#define WATCHDOG_GRACE_MS     1000   /* no safe-state entry during first second after boot */
static uint8_t  in_safe_state = 0;
uint32_t watchdog_trips = 0;
static uint32_t last_safe_blink = 0;
/* USER CODE END PV */

void SystemClock_Config(void);
static void MX_GPIO_Init(void);
static void MX_CAN1_Init(void);
static void MX_USART2_UART_Init(void);
static void MX_TIM3_Init(void);
/* USER CODE BEGIN PFP */
int _write(int file, char *ptr, int len);
void CAN_ReceiverInit(void);
void servo_write(uint16_t pulse_us);
void servo_move_to(uint16_t target_us);
/* USER CODE END PFP */

/**
  * @brief  The application entry point.
  * @retval int
  */
int main(void)
{

  /* MCU Configuration--------------------------------------------------------*/

  /* Reset of all peripherals, Initializes the Flash interface and the Systick. */
  HAL_Init();

  /* Configure the system clock */
  SystemClock_Config();

  /* Initialize all configured peripherals */
  MX_GPIO_Init();
  MX_CAN1_Init();
  MX_USART2_UART_Init();
  MX_TIM3_Init();
  /* USER CODE BEGIN 2 */
  printf("\r\n=== CAN_Receiver_Node (Node B) booted ===\r\n");

  CAN_ReceiverInit();

  HAL_TIM_PWM_Start(&htim3, TIM_CHANNEL_1);

  /* Home the servo to 0° as a known reference position, then move to NORMAL.
     Both moves are rate-limited to avoid browning out the Nucleo 5V rail. */
  servo_write(SERVO_HOME);          /* snap internal state to home  */
  HAL_Delay(400);                   /* let it settle visibly at 0°  */
  servo_move_to(SERVO_NORMAL);      /* gradual move to 30°          */
  printf("Servo homed to 0 deg, moved to NORMAL (30 deg) on TIM3_CH1 (PC6).\r\n");

  /* Seed the heartbeat timestamp so we don't trip safe state before the first beat */
  last_hb_tick = HAL_GetTick();

  printf("CAN ready. Validating CRC + counter integrity + heartbeat watchdog...\r\n\r\n");
  /* USER CODE END 2 */

  /* Infinite loop */
  /* USER CODE BEGIN WHILE */
  while (1)
  {
    /* USER CODE END WHILE */

    /* USER CODE BEGIN 3 */

      /* ---- Sensor frame handling (Day 9) ---- */
      if (can_rx_flag)
      {
          can_rx_flag = 0;

          uint8_t rx_counter = rx_data[0];
          uint8_t crc_calc   = crc8_compute(rx_data, 7);
          uint8_t crc_recv   = rx_data[7];

          if (crc_calc != crc_recv)
          {
              rx_crc_errors++;
              printf("[%lu ms] CRC FAIL cnt=%u recv=0x%02X calc=0x%02X | recv=%lu lost=%lu crcErr=%lu\r\n",
                     HAL_GetTick(), rx_counter, crc_recv, crc_calc,
                     rx_received, rx_lost, rx_crc_errors);
          }
          else
          {
              if (first_frame) {
                  first_frame = 0;
              } else {
                  uint8_t gap = (uint8_t)(rx_counter - expected_counter);
                  if (gap > 0) {
                      rx_lost += gap;
                      printf(">>> LOST %u frame(s) (expected %u, got %u)\r\n",
                             gap, expected_counter, rx_counter);
                  }
              }
              expected_counter = (uint8_t)(rx_counter + 1);
              rx_received++;

              int8_t  temp_int  = (int8_t)rx_data[1];
              uint8_t temp_frac = rx_data[2];
              uint8_t state     = rx_data[3];

              printf("[%lu ms] RX cnt=%u T=%d.%02u st=%u OK | recv=%lu lost=%lu crcErr=%lu\r\n",
                     HAL_GetTick(), rx_counter, temp_int, temp_frac, state,
                     rx_received, rx_lost, rx_crc_errors);
          }
      }

      /* ---- Heartbeat handling (Day 10) ---- */
      if (hb_rx_flag)
      {
          hb_rx_flag = 0;
          hb_count++;
          last_hb_tick = HAL_GetTick();
          printf("  <HB #%u recv @ %lu ms, uptime_lo=%u>\r\n",
                 hb_rx_data[0], last_hb_tick, hb_rx_data[1]);
      }

      /* ---- Heartbeat-timeout watchdog + safe state (Day 11) ---- */
      uint32_t now = HAL_GetTick();
      uint32_t since_hb = now - last_hb_tick;

      /* Grace period: no safe-state entry during the first second after boot. */
      if (now > WATCHDOG_GRACE_MS && since_hb > HEARTBEAT_TIMEOUT_MS)
      {
          if (!in_safe_state)
          {
              in_safe_state = 1;
              watchdog_trips++;
              printf("\r\n*** SAFE STATE: heartbeat timeout (%lu ms) — servo->SAFE, trips=%lu ***\r\n",
                     since_hb, watchdog_trips);
              servo_move_to(SERVO_SAFE);   /* gradual move to 180° fail-safe */
          }

          if (now - last_safe_blink >= 100)
          {
              last_safe_blink = now;
              HAL_GPIO_TogglePin(LD2_GPIO_Port, LD2_Pin);
          }
      }
      else
      {
          if (in_safe_state)
          {
              in_safe_state = 0;
              printf("\r\n*** RECOVERED: heartbeat restored — resuming normal operation ***\r\n");
          }

          switch (rx_data[3])
          {
              case 0:  servo_move_to(SERVO_NORMAL);   break;
              case 1:  servo_move_to(SERVO_WARNING);  break;
              case 2:  servo_move_to(SERVO_CRITICAL); break;
              default: servo_move_to(SERVO_NORMAL);   break;
          }
      }

      HAL_Delay(5);
  }
  /* USER CODE END 3 */
}

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
/* USER CODE BEGIN 4 */

int _write(int file, char *ptr, int len)
{
    HAL_UART_Transmit(&huart2, (uint8_t*)ptr, len, HAL_MAX_DELAY);
    return len;
}

void CAN_ReceiverInit(void)
{
    CAN_FilterTypeDef filter;

    filter.FilterBank = 0;
    filter.FilterMode = CAN_FILTERMODE_IDMASK;
    filter.FilterScale = CAN_FILTERSCALE_32BIT;

    filter.FilterIdHigh = 0x0000;
    filter.FilterIdLow = 0x0000;

    filter.FilterMaskIdHigh = 0x0000;
    filter.FilterMaskIdLow = 0x0000;

    filter.FilterFIFOAssignment = CAN_RX_FIFO0;
    filter.FilterActivation = ENABLE;
    filter.SlaveStartFilterBank = 14;

    HAL_CAN_ConfigFilter(&hcan1, &filter);

    HAL_CAN_Start(&hcan1);

    HAL_CAN_ActivateNotification(
        &hcan1,
        CAN_IT_RX_FIFO0_MSG_PENDING);
}

/* Immediate (un-ramped) write — also syncs the tracked position. */
void servo_write(uint16_t pulse_us)
{
    __HAL_TIM_SET_COMPARE(&htim3, TIM_CHANNEL_1, pulse_us);
    servo_current_us = pulse_us;
}

/* Rate-limited move: step gradually from the current position to the target,
   bounding inrush current so the SG90 runs off the Nucleo 5V rail without
   browning out the board. No-op if already at the target. */
void servo_move_to(uint16_t target_us)
{
    while (servo_current_us != target_us)
    {
        if (target_us > servo_current_us)
        {
            servo_current_us = (target_us - servo_current_us > SERVO_STEP_US)
                               ? servo_current_us + SERVO_STEP_US : target_us;
        }
        else
        {
            servo_current_us = (servo_current_us - target_us > SERVO_STEP_US)
                               ? servo_current_us - SERVO_STEP_US : target_us;
        }
        __HAL_TIM_SET_COMPARE(&htim3, TIM_CHANNEL_1, servo_current_us);
        HAL_Delay(SERVO_STEP_DELAY);
    }
}

void HAL_CAN_RxFifo0MsgPendingCallback(CAN_HandleTypeDef *hcan)
{
    CAN_RxHeaderTypeDef hdr;
    uint8_t data[8];

    if (HAL_CAN_GetRxMessage(hcan, CAN_RX_FIFO0, &hdr, data) == HAL_OK)
    {
        if (hdr.StdId == 0x100) {          /* heartbeat */
            hb_rx_data[0] = data[0];
            hb_rx_data[1] = data[1];
            hb_rx_flag = 1;
        } else {                           /* sensor frame (0x123) */
            rx_header = hdr;
            for (int i = 0; i < 8; i++) rx_data[i] = data[i];
            can_rx_flag = 1;
        }
    }
}

/* USER CODE END 4 */
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
