chenyurong22/industrial-safety-can/CAN_Sender_Node/Core/Src/main.c

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
/* Includes ------------------------------------------------------------------*/
#include "main.h"
#include "can.h"
#include "i2c.h"
#include "usart.h"
#include "gpio.h"

/* USER CODE BEGIN Includes */
#include <stdio.h>
#include <string.h>
#include "bme280.h"
#include "state_machine.h"
#include "crc8.h"
/* USER CODE END Includes */


/* USER CODE BEGIN PV */
static SystemState current_state = STATE_NORMAL;
static SystemState previous_state = STATE_NORMAL;

/* CAN handles */
CAN_TxHeaderTypeDef tx_header;
CAN_RxHeaderTypeDef rx_header;
uint8_t tx_data[8] = {0};
uint8_t rx_data[8] = {0};
uint32_t tx_mailbox;
volatile uint8_t can_rx_flag = 0;  /* set by ISR when frame arrives */
volatile uint8_t can_rx_count = 0;

static uint8_t msg_counter = 0;  /* wraps at 256 */

/* Heartbeat — separate CAN ID, independent cadence */
CAN_TxHeaderTypeDef hb_header;
uint8_t hb_data[8] = {0};
static uint8_t hb_counter = 0;

/* Tick-based scheduling timestamps */
static uint32_t last_sensor_tx = 0;
static uint32_t last_heartbeat_tx = 0;


/* USER CODE END PV */

void SystemClock_Config(void);

/* USER CODE BEGIN PFP */
int _write(int file, char *ptr, int len);
void CAN_TestInit(void);
HAL_StatusTypeDef CAN_SendSensorFrame(float temp_c, SystemState state);
HAL_StatusTypeDef CAN_SendHeartbeat(void);
/* USER CODE END PFP */

/**
  * @brief  The application entry point.
  * @retval int
  */
int main(void)
{

  /* MCU Configuration--------------------------------------------------------*/

  /* Reset of all peripherals, Initializes the Flash interface and the Systick. */
  HAL_Init();

  /* Configure the system clock */
  SystemClock_Config();

  /* Initialize all configured peripherals */
  MX_GPIO_Init();
  MX_USART2_UART_Init();
  MX_I2C1_Init();
  MX_CAN1_Init();
  /* USER CODE BEGIN 2 */
  printf("\r\n=== CAN_Sender_Node booted ===\r\n");

    if (BME280_Init() == HAL_OK) {
        printf("BME280 calibrated and configured.\r\n\r\n");
    } else {
        printf("BME280 init FAILED.\r\n\r\n");
        while (1) { /* halt */ }
    }

    //* CAN test initialization */
  CAN_TestInit();
  printf("CAN initialized in NORMAL mode @ 500 kbit/s.\r\n");
  printf("Frame format: [counter|temp_int|temp_frac|state|0|0|0|CRC8]\r\n\r\n");
  /* USER CODE END 2 */

  /* Infinite loop */
  /* USER CODE BEGIN WHILE */
  while (1)
  {
	  /* USER CODE END WHILE */
	        /* USER CODE BEGIN 3 */
	        uint32_t now = HAL_GetTick();

	        /* Sensor frame every 100 ms */
	        if (now - last_sensor_tx >= 100)
	        {
	            last_sensor_tx = now;

	            float temp_c, hum_pct, press_hpa;
	            if (BME280_Read(&temp_c, &hum_pct, &press_hpa) == HAL_OK) {
	                current_state = classify_state(temp_c, current_state);
	                if (current_state != previous_state) {
	                    printf("*** STATE: %s -> %s ***\r\n",
	                           state_name(previous_state), state_name(current_state));
	                    previous_state = current_state;
	                }

	                if (CAN_SendSensorFrame(temp_c, current_state) == HAL_OK) {
	                    printf("TX #%u: T=%.2f C state=%s  CRC=0x%02X\r\n",
	                           (uint8_t)(msg_counter - 1),
	                           temp_c, state_name(current_state), tx_data[7]);
	                } else {
	                    printf("TX failed (CAN error: 0x%08lX)\r\n", HAL_CAN_GetError(&hcan1));
	                }
	            }

	            HAL_GPIO_TogglePin(LD2_GPIO_Port, LD2_Pin);
	        }

	        /* Heartbeat every 200 ms, independent of sensor cadence */
	        if (now - last_heartbeat_tx >= 200)
	        {
	            last_heartbeat_tx = now;
	            if (CAN_SendHeartbeat() == HAL_OK) {
	                printf("  [HB #%u @ %lu ms]\r\n", (uint8_t)(hb_counter - 1), now);
	            }
	        }
	    }
	    /* USER CODE END 3 */
}

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
/* USER CODE BEGIN 4 */
int _write(int file, char *ptr, int len)
{
    HAL_UART_Transmit(&huart2, (uint8_t *)ptr, len, HAL_MAX_DELAY);
    return len;
}

/* ----------------------------------------------------------
 * CAN initialization
 * ---------------------------------------------------------- */
void CAN_TestInit(void)
{
    /* Configure RX filter — accept all standard IDs (mask = 0) */
    CAN_FilterTypeDef filter;
    filter.FilterBank = 0;
    filter.FilterMode = CAN_FILTERMODE_IDMASK;
    filter.FilterScale = CAN_FILTERSCALE_32BIT;
    filter.FilterIdHigh = 0x0000;
    filter.FilterIdLow  = 0x0000;
    filter.FilterMaskIdHigh = 0x0000;
    filter.FilterMaskIdLow  = 0x0000;
    filter.FilterFIFOAssignment = CAN_RX_FIFO0;
    filter.FilterActivation = ENABLE;
    filter.SlaveStartFilterBank = 14;
    HAL_CAN_ConfigFilter(&hcan1, &filter);

    /* Start CAN peripheral */
    HAL_CAN_Start(&hcan1);

    /* Enable RX FIFO0 interrupt */
    HAL_CAN_ActivateNotification(&hcan1, CAN_IT_RX_FIFO0_MSG_PENDING);

    /* Configure TX header — 8-byte payload for counter + data + CRC */
    tx_header.StdId = 0x123;
    tx_header.ExtId = 0;
    tx_header.IDE = CAN_ID_STD;
    tx_header.RTR = CAN_RTR_DATA;
    tx_header.DLC = 8;
    tx_header.TransmitGlobalTime = DISABLE;

    /* Heartbeat header — ID 0x100, DLC 2 (counter + uptime low byte) */
        hb_header.StdId = 0x100;
        hb_header.ExtId = 0;
        hb_header.IDE = CAN_ID_STD;
        hb_header.RTR = CAN_RTR_DATA;
        hb_header.DLC = 2;
        hb_header.TransmitGlobalTime = DISABLE;
}

/* ----------------------------------------------------------
 * Build and transmit a sensor frame with counter + CRC
 *
 * Frame layout (8 bytes):
 *   [0]    Rolling message counter (wraps at 256)
 *   [1]    Temperature integer part (signed °C)
 *   [2]    Temperature fractional × 100 (0..99)
 *   [3]    System state enum (0=NORMAL, 1=WARNING, 2=CRITICAL)
 *   [4-6]  Reserved (0x00) — future: humidity, pressure
 *   [7]    CRC-8 over bytes 0..6 (polynomial 0x07)
 * ---------------------------------------------------------- */
HAL_StatusTypeDef CAN_SendSensorFrame(float temp_c, SystemState state)
{
    tx_data[0] = msg_counter;

    int16_t temp_int  = (int16_t)temp_c;
    uint8_t temp_frac = (uint8_t)((temp_c - temp_int) * 100.0f);
    tx_data[1] = (uint8_t)temp_int;
    tx_data[2] = temp_frac;

    tx_data[3] = (uint8_t)state;

    tx_data[4] = 0x00;
    tx_data[5] = 0x00;
    tx_data[6] = 0x00;

    tx_data[7] = crc8_compute(tx_data, 7);

    msg_counter++;  /* uint8_t wraps naturally at 256 */

    return HAL_CAN_AddTxMessage(&hcan1, &tx_header, tx_data, &tx_mailbox);
}

    HAL_StatusTypeDef CAN_SendHeartbeat(void)
    {
        uint32_t tick = HAL_GetTick();
        hb_data[0] = hb_counter++;            /* rolling heartbeat counter */
        hb_data[1] = (uint8_t)(tick / 100);   /* coarse uptime low byte */

        uint32_t mailbox;
        return HAL_CAN_AddTxMessage(&hcan1, &hb_header, hb_data, &mailbox);
    }

/* ----------------------------------------------------------
 * RX interrupt callback (kept for completeness — Node A
 * doesn't receive its own frames in Normal mode, but the
 * callback must exist because HAL_CAN_ActivateNotification
 * was called for FIFO0)
 * ---------------------------------------------------------- */
void HAL_CAN_RxFifo0MsgPendingCallback(CAN_HandleTypeDef *hcan)
{
    if (HAL_CAN_GetRxMessage(hcan, CAN_RX_FIFO0, &rx_header, rx_data) == HAL_OK) {
        can_rx_flag = 1;
        can_rx_count++;
    }
}

/* USER CODE END 4 */
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
