chenyurong22/industrial-safety-can/(commit log)

2026-05-13 Day 1: toolchain setup and LED blink on Nucleo-F446RE
2026-05-14 Day 2: UART printf retarget + profiling; docs with Day 1/2 screenshots; MIT license
2026-05-15 Day 3: I2C1 enabled; BME280 detected at 0x76; chip ID verified (0x60)
2026-05-17 Day 4: BME280 driver with calibration + live T/H/P readings every 1s
2026-05-19 Day 5: temperature state machine with edge-triggered transitions and state-driven LED rate
2026-05-20 Day 6: extract state_machine module; add 2C hysteresis to prevent threshold flapping
    [main.c, state_machine.c, state_machine.h]
2026-05-22 Day 7: CAN1 loopback test - peripheral, filter, ISR-driven RX all validated
2026-06-01 Day 8: two-node CAN bus over real wires - 500 kbit/s, terminated, ACKed
2026-06-25 Restructure: rename projects to CAN_Sender_Node / CAN_Receiver_Node, images to Project-Snaps
    [CAN_Receiver_Node.ioc, CAN_Sender_Node.ioc, bme280.c, bme280.h, crc8.c, crc8.h, main.c]
2026-06-27 Day 11: safe-state watchdog with heartbeat-timeout supervision and PWM fail-safe actuation
    [CAN_Receiver_Node.ioc, main.c]
2026-06-28 Day 12: hardware fault injection with logic-analyzer bus capture and three-layer evidence chain
2026-07-02 Day 13: Python CAN logger — listen-only observer with independent CRC + counter validation, RX-FIFO drain, and fault-injection capture
    [can_log.csv]
2026-07-02 Day 14: docs/ structure, architecture + HARA + requirements + MISRA reports, MISRA fixes, README finalization
    [crc8.c, state_machine.c]
