chenyurong22/industrial-safety-can/(notices)

Notices in the files:
CAN_Sender_Node/Core/Src/main.c:
Copyright (c) 2026 STMicroelectronics.
All rights reserved.
This software is licensed under terms that can be found in the LICENSE file
